pollen-robotics/lib_KiCAD/Templates/ASE00xyz-A1_elec_template_BOM.xlsx

ASE00 | A1 | Rainbow | DD/MM/202Y
Ref. | Value | Description | Quantity | Man. | Man. Ref.
