pollen-robotics/lib_KiCAD/3d_models/header_3p_215297-3.step

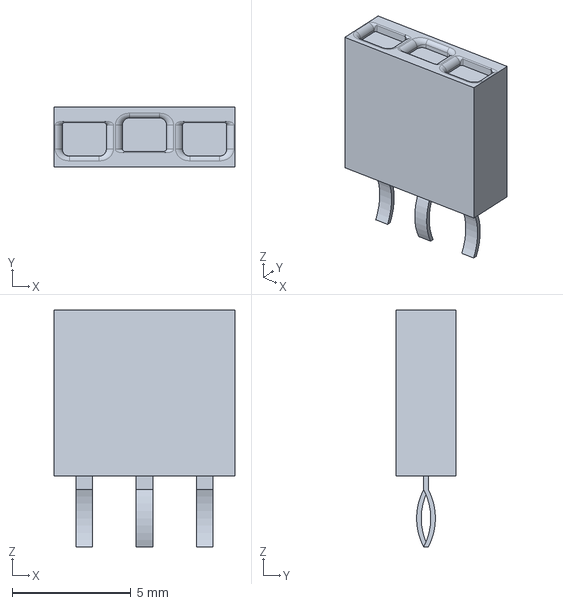
[picture p2: CAD file, 2026-09-16]
3d_models/header_3p_215297-3.step
7.62 x 2.52 x 10.0 mm
