pollen-robotics/lib_KiCAD/3d_models/RQM0029A.stp

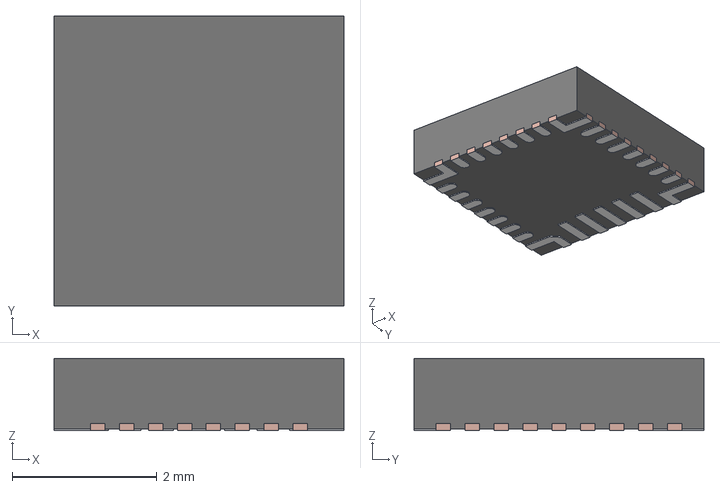
[picture p3: CAD file, 2026-09-15]
3d_models/RQM0029A.stp
4.00 x 4.00 x 1.00 mm
FRAME
MOLD
