pollen-robotics/lib_KiCAD/3d_models/HVQFN-32_L5.0-W5.0-P0.50-TL-EP3.1.step

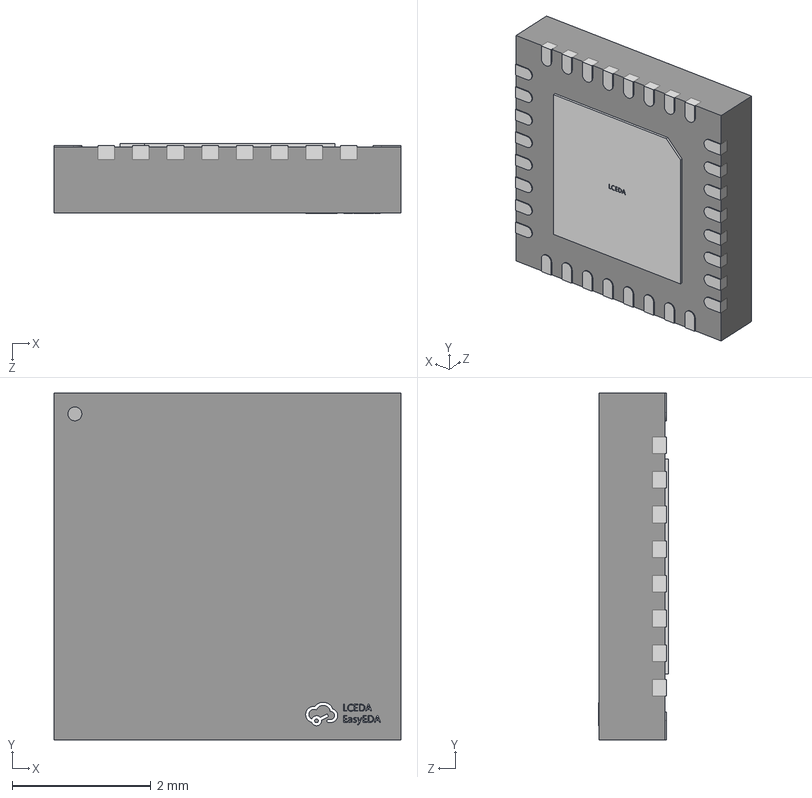
[picture p4: CAD file, 2026-07-10]
3d_models/HVQFN-32_L5.0-W5.0-P0.50-TL-EP3.1.step
5.00 x 5.00 x 1.01 mm
