pollen-robotics/lib_KiCAD/3d_models/Molex_pico4_TH_RA_0530480410.stp

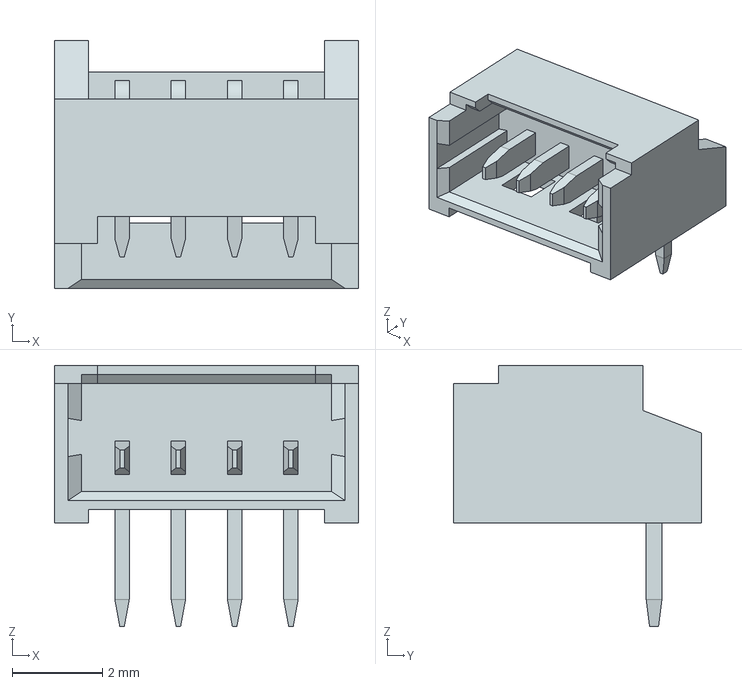
[picture p5: CAD file, 2026-04-16]
3d_models/Molex_pico4_TH_RA_0530480410.stp
6.75 x 5.50 x 5.80 mm
