pollen-robotics/lib_KiCAD/3d_models/Kailh_Choc_Low_Profile_Switch.step

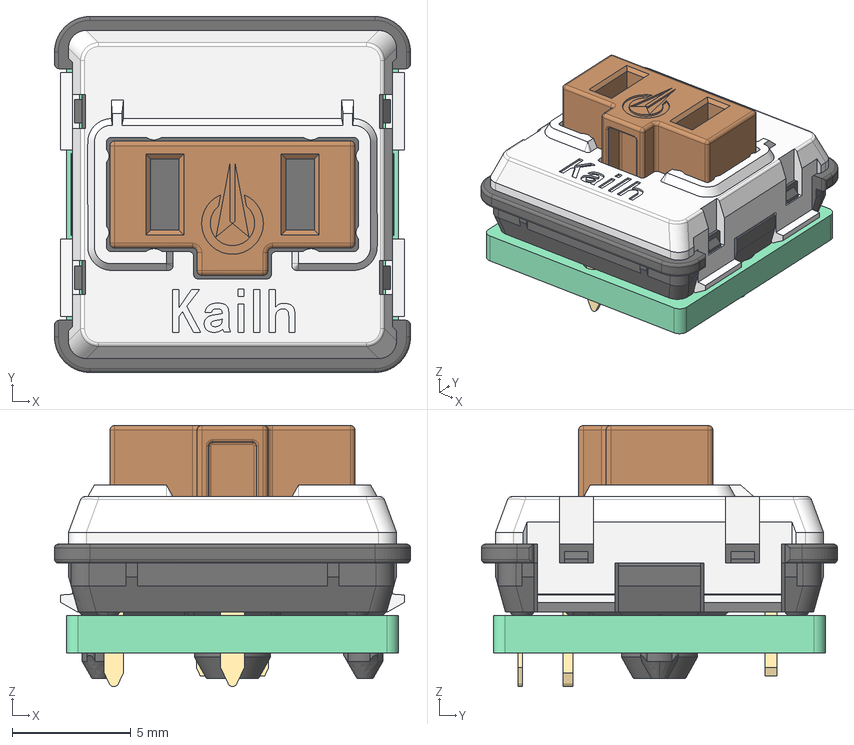
[picture p6: CAD file, 2026-03-20]
3d_models/Kailh_Choc_Low_Profile_Switch.step
15.0 x 15.0 x 11.0 mm
