pollen-robotics/lib_KiCAD/3d_models/rasp_pi_zero_2_W_with_40_pin_male_connector v4.step

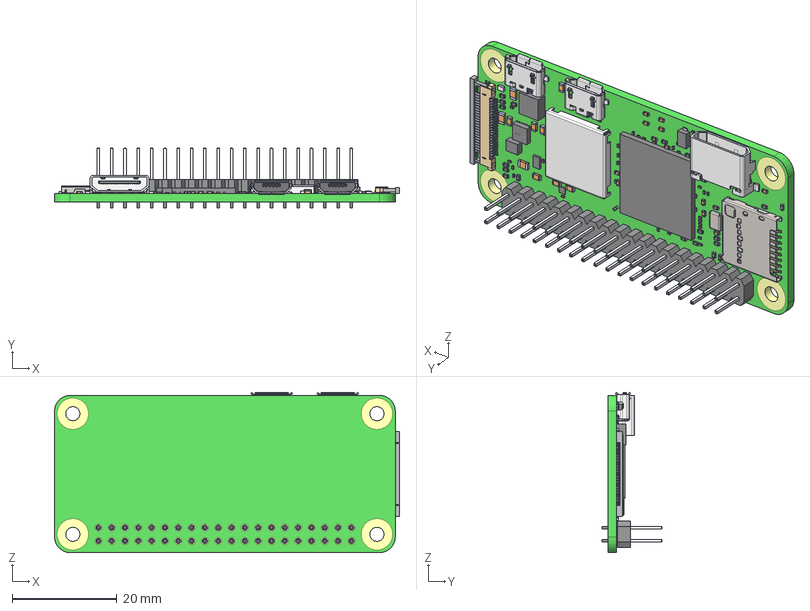
[picture p7: CAD file, 2026-02-24]
3d_models/rasp_pi_zero_2_W_with_40_pin_male_connector v4.step
65.8 x 11.5 x 30.6 mm
PCB, Raspberry Pi Zero 2 W
RP3A0-AU 2105 201221C, Raspberry Pi Zero 2 W
MicroUSB Port, Raspberry Pi Zero 2 W x 2
SD Card Slot, Raspberry Pi Zero 2 W
Wireless Module Cover, Raspberry Pi Zero 2 W
Crystal Resonator, Raspberry Pi Zero 2 W
LED, Raspberry Pi Zero 2 W
Diode, Schottky, Raspberry Pi Zero 2 W
54548-2271, 22 Pin FPC Connector, Raspberry Pi Zero 2 W
Mini HDMI Receptacle Port, Raspberry Pi Zero 2 W
PAM2306AYPKE, Switching Voltage Regulators Dual PWM Step-Down 40uA 1A 1.5MHz, Raspberry Pi Zero 2 W
RT9081A-1BGQZA, Fixed LDO Voltage Regulator, 0.8V-5.5Vin, 140mV drop, 1.25Vout, 0.5Aout, Raspberry Pi Zero 2 W_default
RT8088AWSC, IC Reg Buck Prog 3A Sync 15WLCSP, Raspberry Pi Zero 2 W_d efault
SMD Inductor, Configurable, Raspberry Pi Zero 2 W_L1
SMD Inductor, Configurable, Raspberry Pi Zero 2 W_L2
SMD Capacitor, Configurable, Raspberry Pi Zero 2 W_C1 x 3
SMD Capacitor, Configurable, Raspberry Pi Zero 2 W_C3 x 7
SMD Capacitor, Configurable, Raspberry Pi Zero 2 W_C2 x 31
SMD Capacitor, Configurable, Raspberry Pi Zero 2 W_C10 x 15
SMD Resistor, Configurable, Raspberry Pi Zero 2 W_R1 x 20
SMD Resistor, Configurable, Raspberry Pi Zero 2 W_R12
40 pin header male Raspberry PI v1
