pollen-robotics/lib_KiCAD/3d_models/Molex_pico4_TH_0530470410.stp

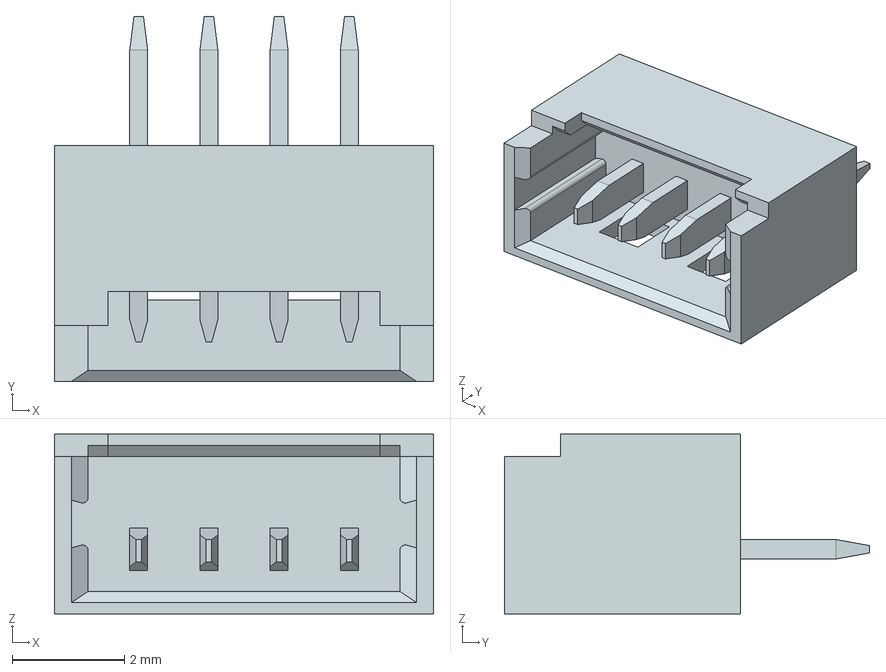
[picture p8: CAD file, 2026-02-09]
3d_models/Molex_pico4_TH_0530470410.stp
6.75 x 6.50 x 3.20 mm
