pollen-robotics/lib_KiCAD/3d_models/raps_CM4 -Light.step

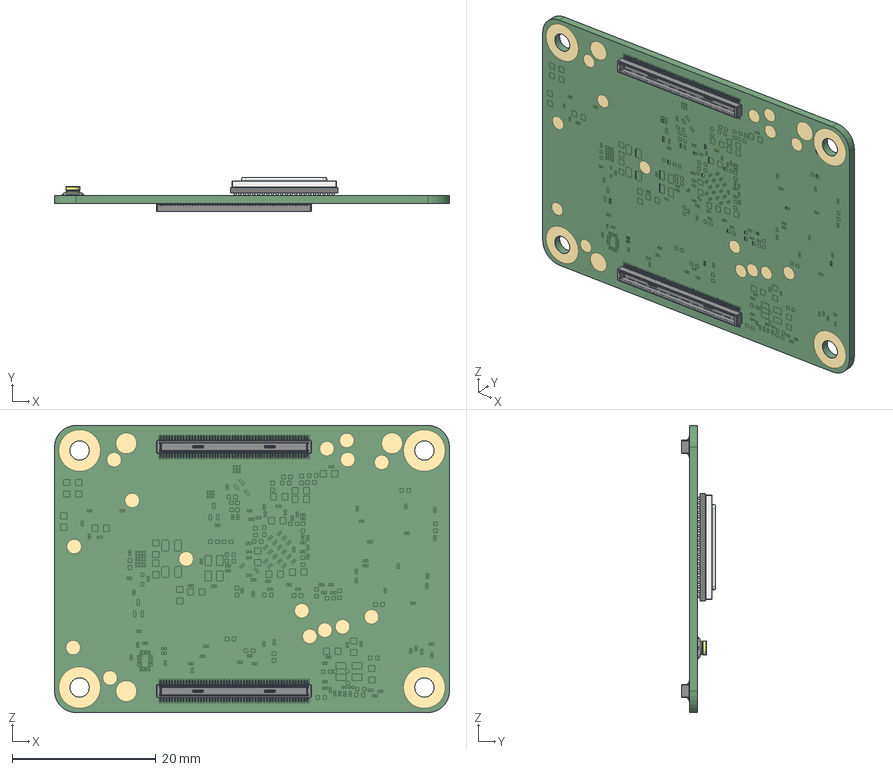
[picture p9: CAD file, 2026-01-26]
3d_models/raps_CM4 -Light.step
55.0 x 4.78 x 40.0 mm
