pollen-robotics/lib_KiCAD/3d_models/rasp_Cooler_RPI_CMx.step

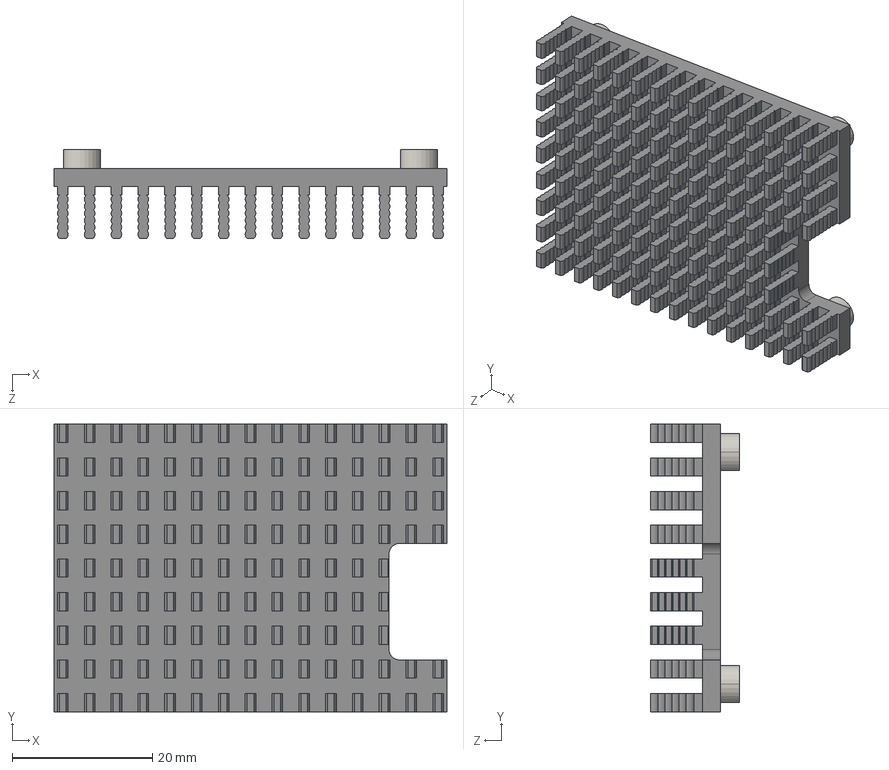
[picture p10: CAD file, 2026-01-26]
3d_models/rasp_Cooler_RPI_CMx.step
56.0 x 41.0 x 12.7 mm
