pollen-robotics/lib_KiCAD/3d_models/rasp_AI_HAT_Plus.stp

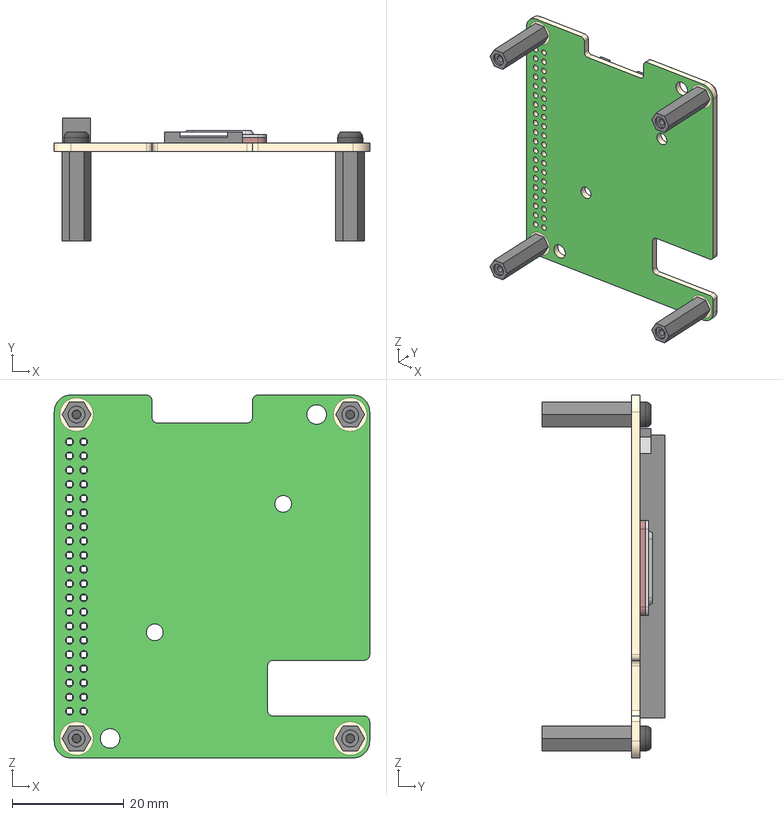
[picture p11: CAD file, 2026-01-26]
3d_models/rasp_AI_HAT_Plus.stp
56.5 x 22.1 x 65.0 mm
RPiAIHATPlusBoard
RPiAIHATPlusLeg x 4
RPiAIHATPlusScrew x 4
