pollen-robotics/lib_KiCAD/3d_models/Amass_XT30UPB-F.step

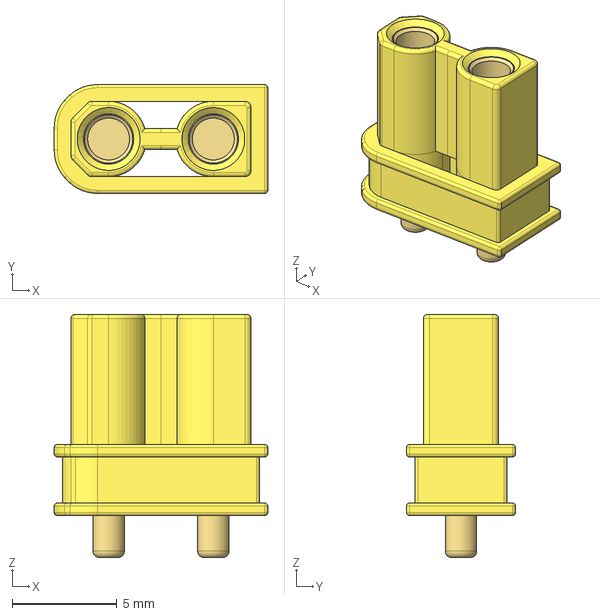
[picture p12: CAD file, 2025-12-03]
3d_models/Amass_XT30UPB-F.step
10.2 x 5.20 x 11.6 mm
