pollen-robotics/lib_KiCAD/3d_models/Vishay_SiC402_PowerPAK MLP55-32L.step

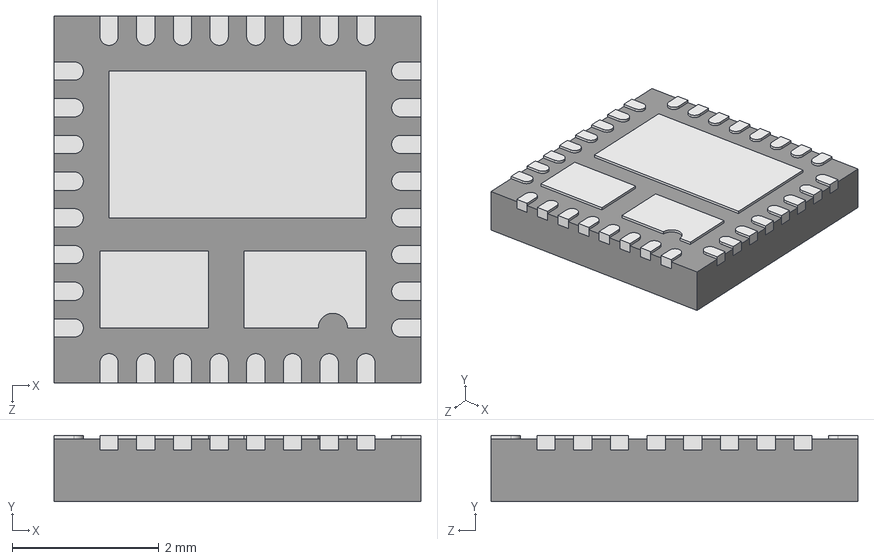
[picture p13: CAD file, 2025-11-20]
3d_models/Vishay_SiC402_PowerPAK MLP55-32L.step
5.00 x 0.9 x 5.00 mm
SiC402_body
SiC402_pinGND
SiC402_pinLX
SiC402_pinVIN
SiC402_pin x 32
SiC402_pinMark
