pollen-robotics/lib_KiCAD/3d_models/Amphenol_LUSBA11100.STEP

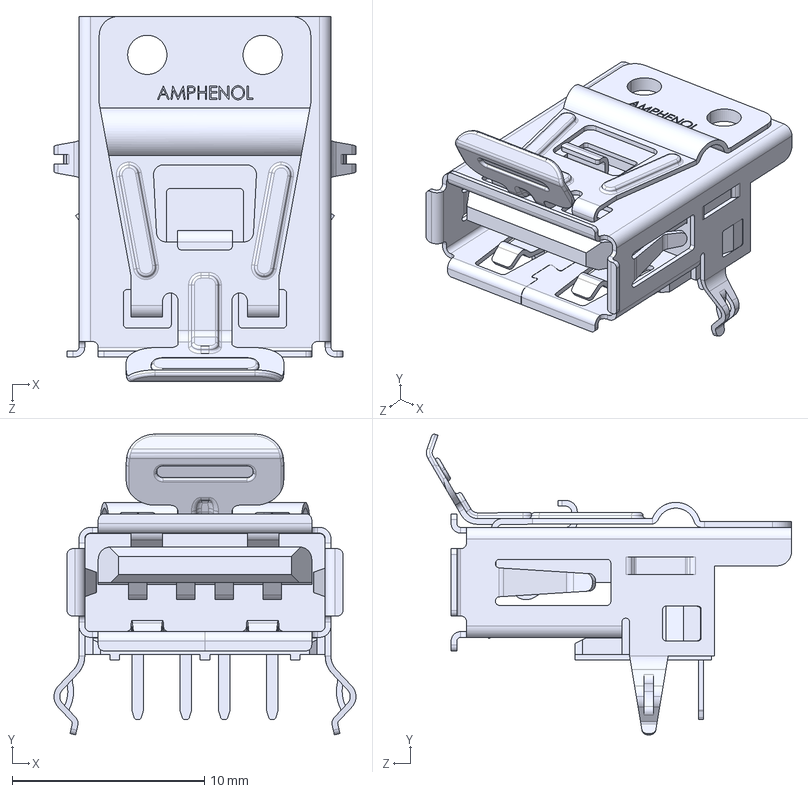
[picture p14: CAD file, 2025-10-06]
3d_models/Amphenol_LUSBA11100.STEP
15.7 x 15.6 x 19.0 mm
