pollen-robotics/lib_KiCAD/3d_models/Molex_430450612.stp

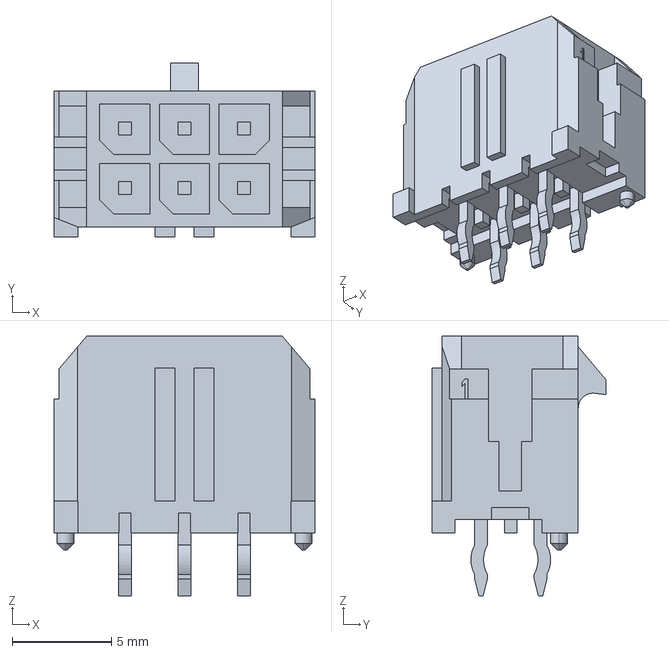
[picture p15: CAD file, 2025-09-02]
3d_models/Molex_430450612.stp
13.2 x 8.77 x 13.1 mm
