pollen-robotics/lib_KiCAD/3d_models/Amass_XT90PB-F.STEP

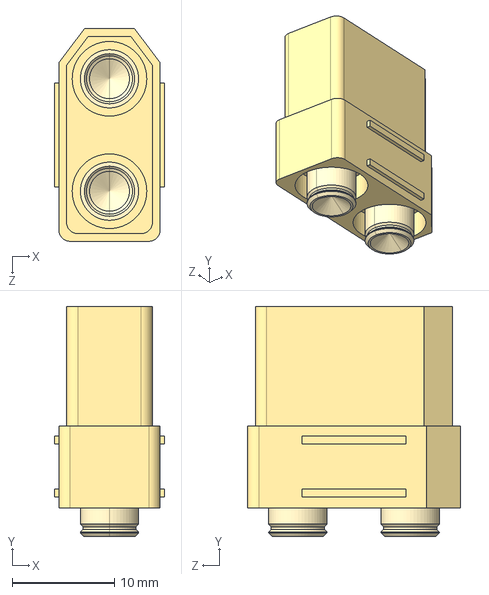
[picture p16: CAD file, 2025-09-02]
3d_models/Amass_XT90PB-F.STEP
10.8 x 22.5 x 20.8 mm
