pollen-robotics/lib_KiCAD/3d_models/TE_1734366-1.stp

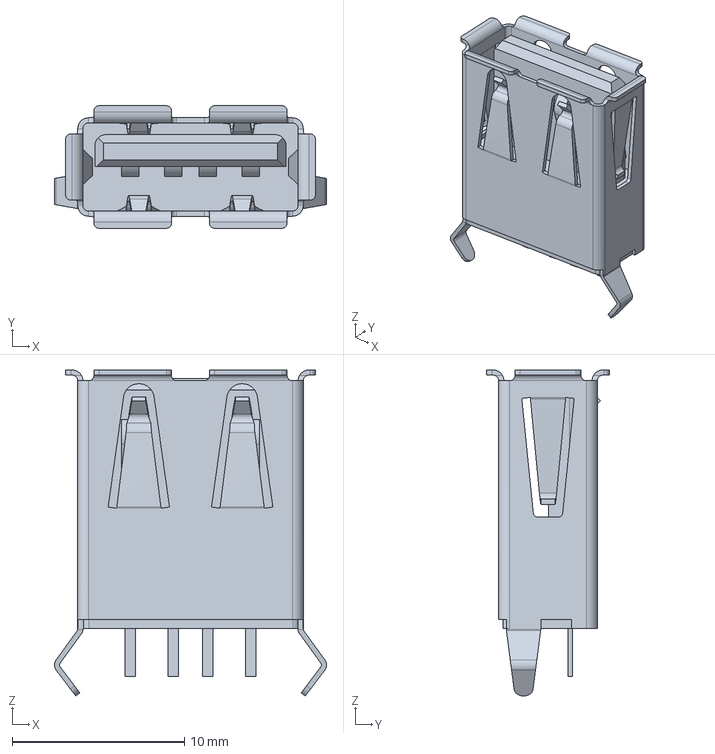
[picture p17: CAD file, 2025-09-02]
3d_models/TE_1734366-1.stp
15.8 x 7.12 x 18.9 mm
