pollen-robotics/lib_KiCAD/3d_models/MPKSLE60D20-L.step

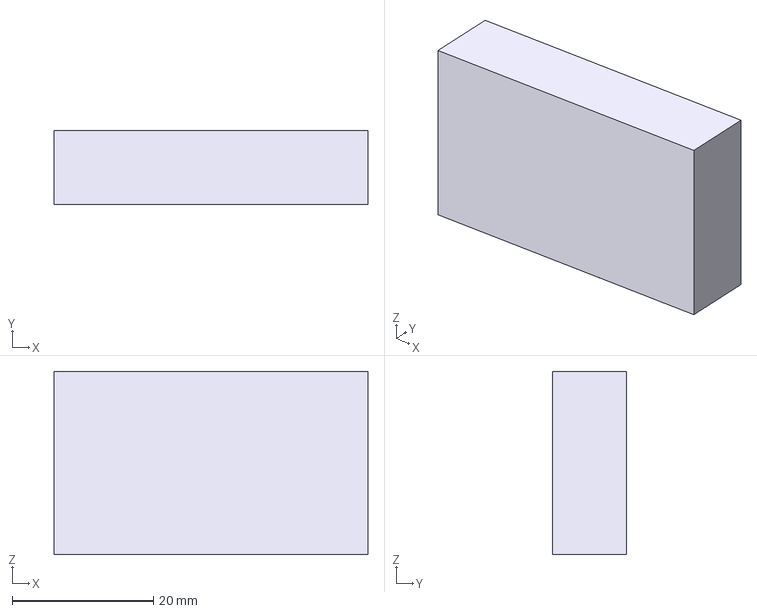
[picture p18: CAD file, 2025-09-02]
3d_models/MPKSLE60D20-L.step
44.5 x 10.5 x 26.0 mm
