pollen-robotics/lib_KiCAD/3d_models/Shou Han - USB TYPE-C 16PIN 2MD -073---3DModel-STEP-269445.STEP

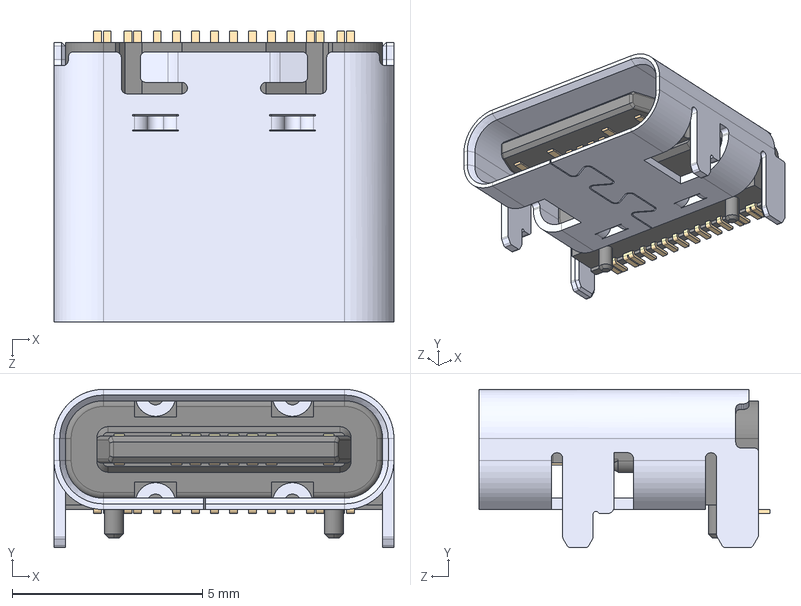
[picture p19: CAD file, 2025-06-26]
3d_models/Shou Han - USB TYPE-C 16PIN 2MD -073---3DModel-STEP-269445.STEP
8.94 x 4.16 x 7.65 mm
