pollen-robotics/lib_KiCAD/3d_models/FOO_USB-C_vert.STEP

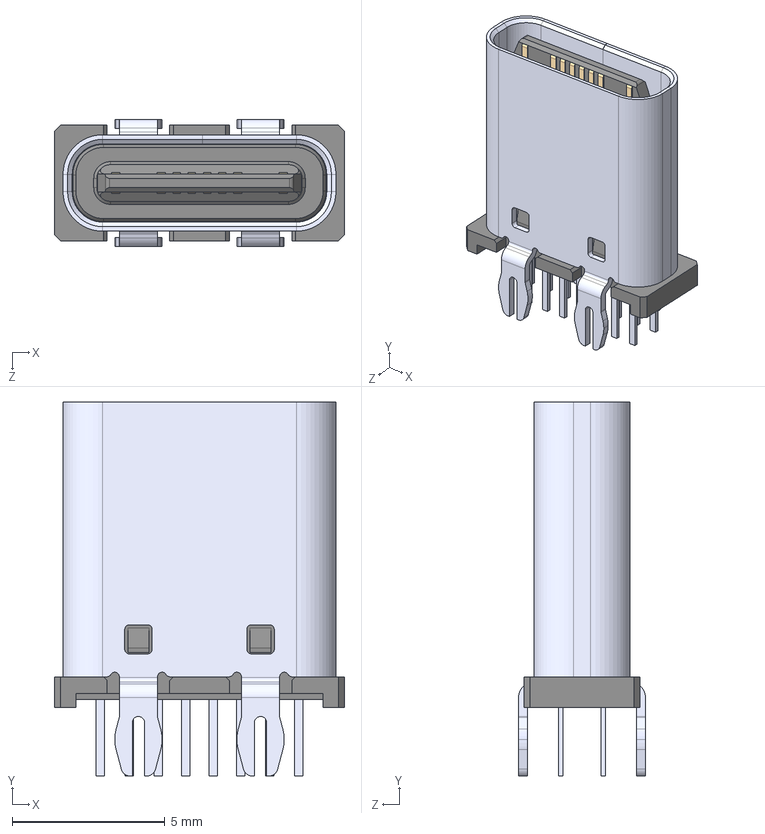
[picture p20: CAD file, 2025-06-26]
3d_models/FOO_USB-C_vert.STEP
9.50 x 12.2 x 4.16 mm
