pollen-robotics/lib_KiCAD/3d_models/DC005_jack_barrel.STEP

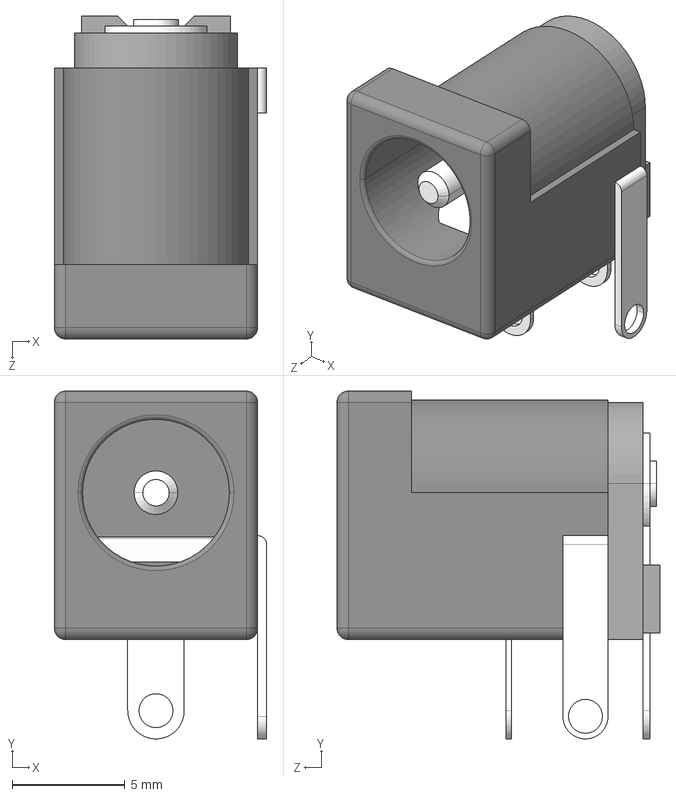
[picture p21: CAD file, 2025-06-26]
3d_models/DC005_jack_barrel.STEP
9.40 x 15.4 x 14.3 mm
