pollen-robotics/lib_KiCAD/3d_models/ss-3336s-02-l1.stp

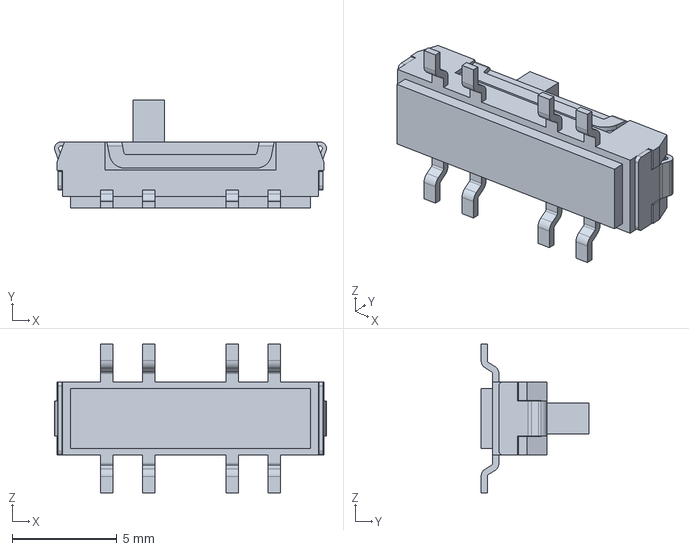
[picture p22: CAD file, 2025-06-26]
3d_models/ss-3336s-02-l1.stp
13.0 x 5.15 x 7.10 mm
