pollen-robotics/lib_KiCAD/3d_models/PowerSO20.STEP

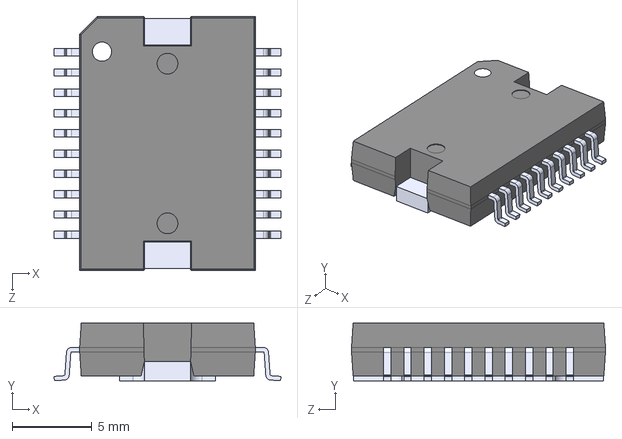
[picture p23: CAD file, 2025-06-26]
3d_models/PowerSO20.STEP
14.2 x 3.60 x 15.9 mm
