pollen-robotics/lib_KiCAD/3d_models/EOZ_09.03201.02.step

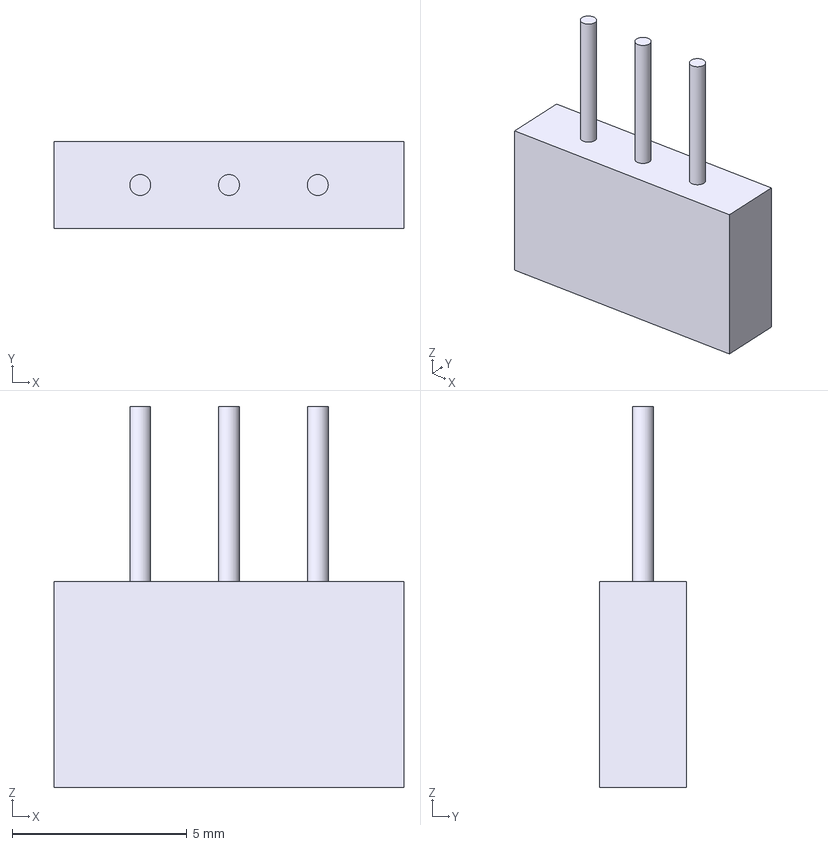
[picture p24: CAD file, 2025-02-03]
3d_models/EOZ_09.03201.02.step
10.0 x 2.50 x 10.9 mm
