pollen-robotics/lib_KiCAD/3d_models/Molex_430450212.stp

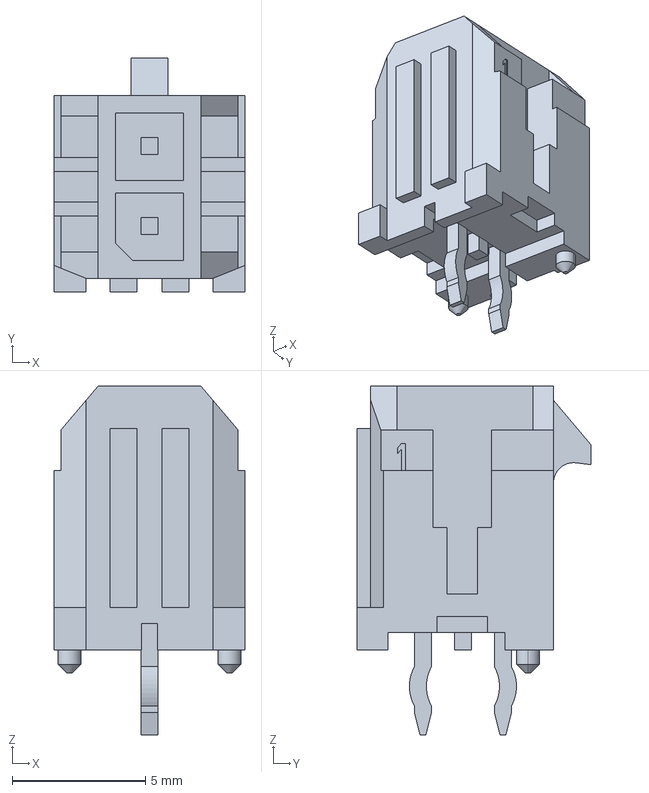
[picture p25: CAD file, 2024-11-15]
3d_models/Molex_430450212.stp
7.15 x 8.77 x 13.1 mm
