pollen-robotics/lib_KiCAD/3d_models/Molex_436500221.stp

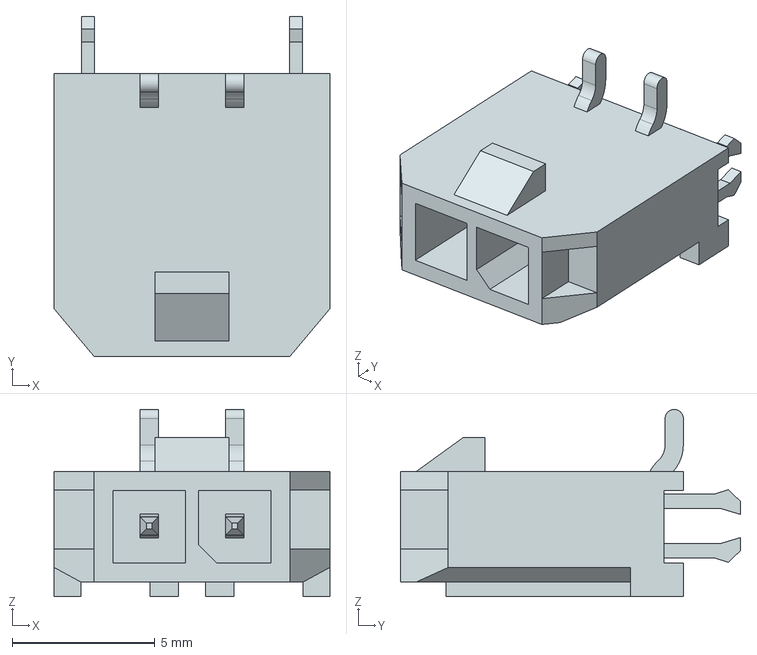
[picture p26: CAD file, 2024-11-07]
3d_models/Molex_436500221.stp
9.65 x 11.9 x 6.55 mm
