pollen-robotics/lib_KiCAD/3d_models/LPQFN20_ADI.step

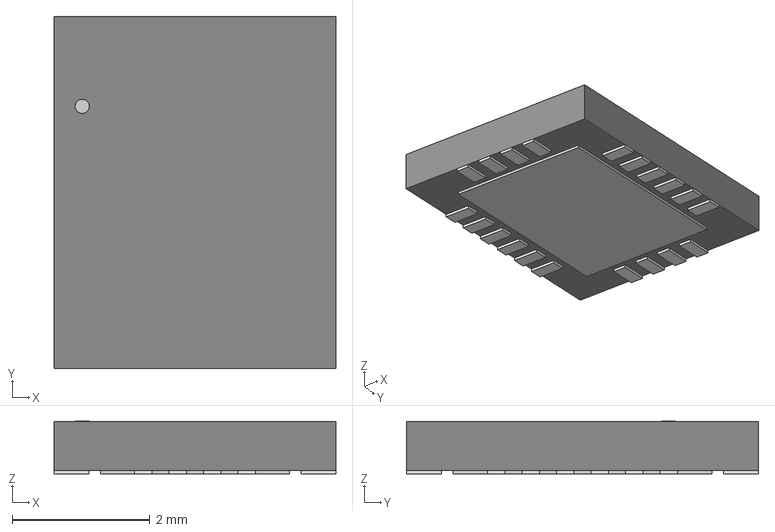
[picture p27: CAD file, 2024-10-08]
3d_models/LPQFN20_ADI.step
4.09 x 5.11 x 0.765 mm
