pollen-robotics/lib_KiCAD/3d_models/QFN-16 (3x3).stp

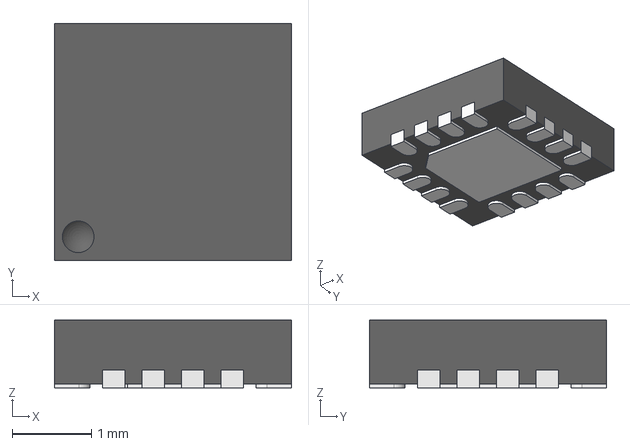
[picture p28: CAD file, 2024-09-25]
3d_models/QFN-16 (3x3).stp
3.00 x 3.00 x 0.86 mm
QFN-16 (3x3) Part1
QFN-16 (3x3) Part2 x 16
