pollen-robotics/lib_KiCAD/3d_models/TE_5787834-1.stp

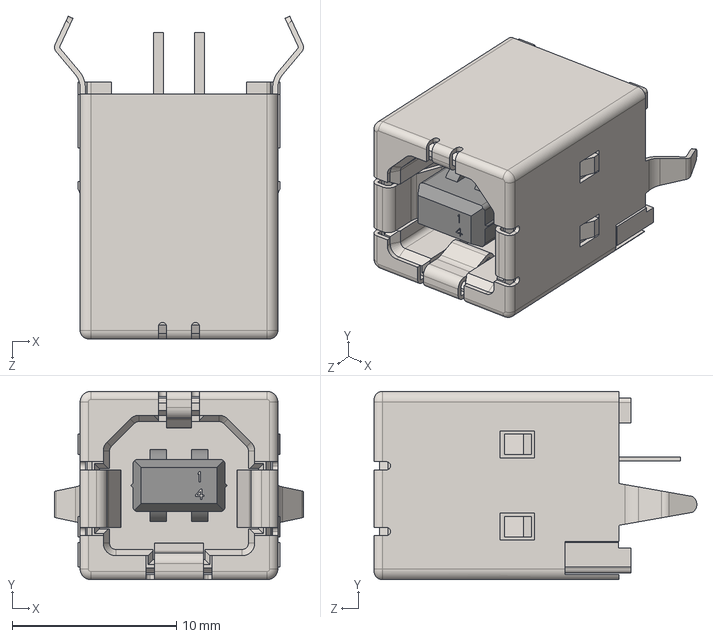
[picture p29: CAD file, 2024-08-23]
3d_models/TE_5787834-1.stp
15.1 x 11.5 x 19.6 mm
