pollen-robotics/lib_KiCAD/3d_models/Molex_105133-0001.stp

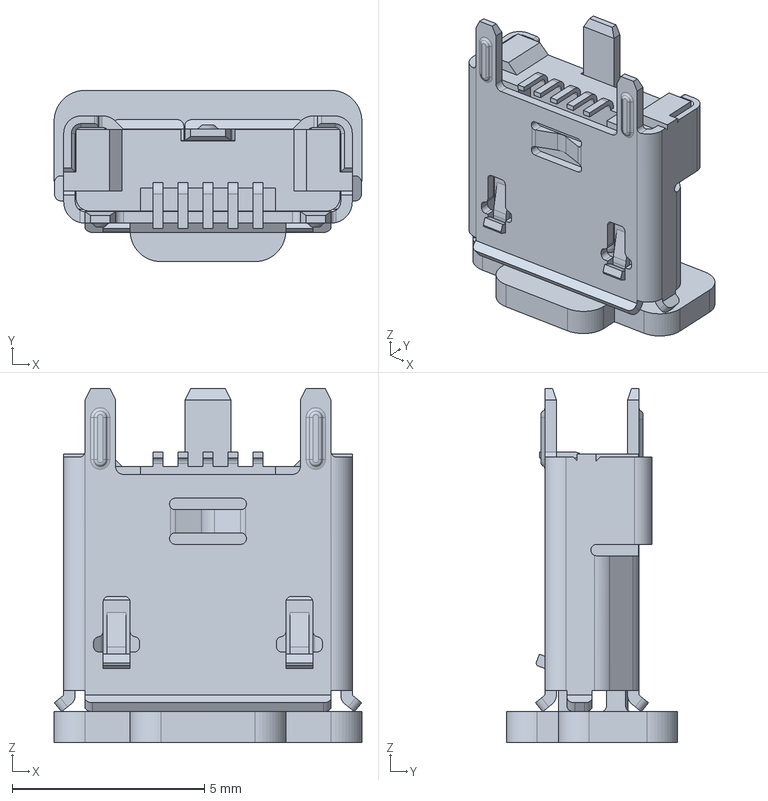
[picture p30: CAD file, 2024-08-23]
3d_models/Molex_105133-0001.stp
8.00 x 4.45 x 9.20 mm
