pollen-robotics/lib_KiCAD/3d_models/ERJ8CWFR010V.step

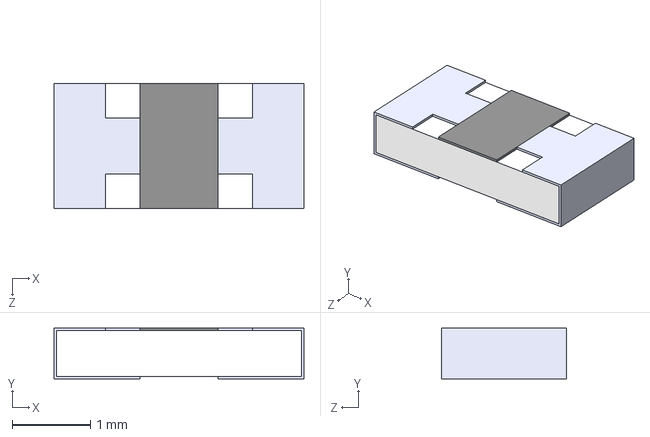
[picture p31: CAD file, 2024-07-12]
3d_models/ERJ8CWFR010V.step
3.20 x 0.65 x 1.60 mm
