pollen-robotics/lib_KiCAD/3d_models/Molex_539160208.stp

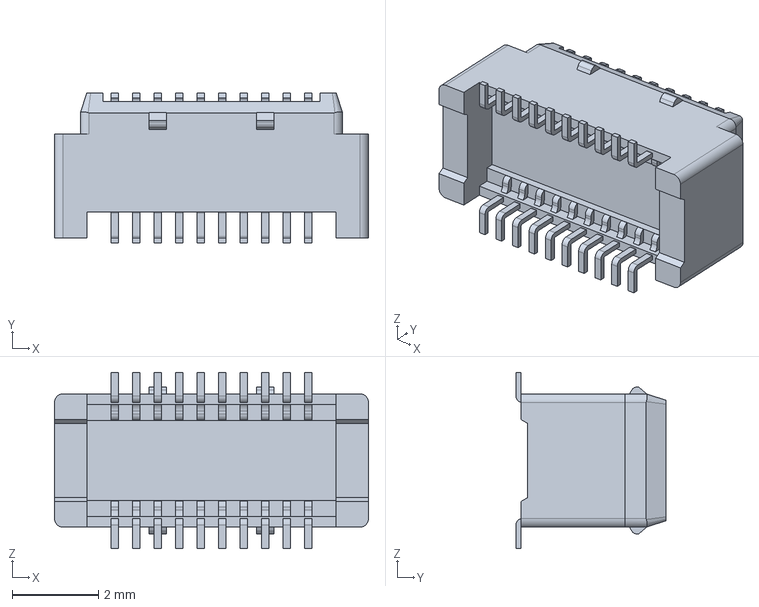
[picture p32: CAD file, 2024-05-10]
3d_models/Molex_539160208.stp
7.30 x 3.49 x 4.10 mm
