pollen-robotics/lib_KiCAD/3d_models/Molex_529910208.stp

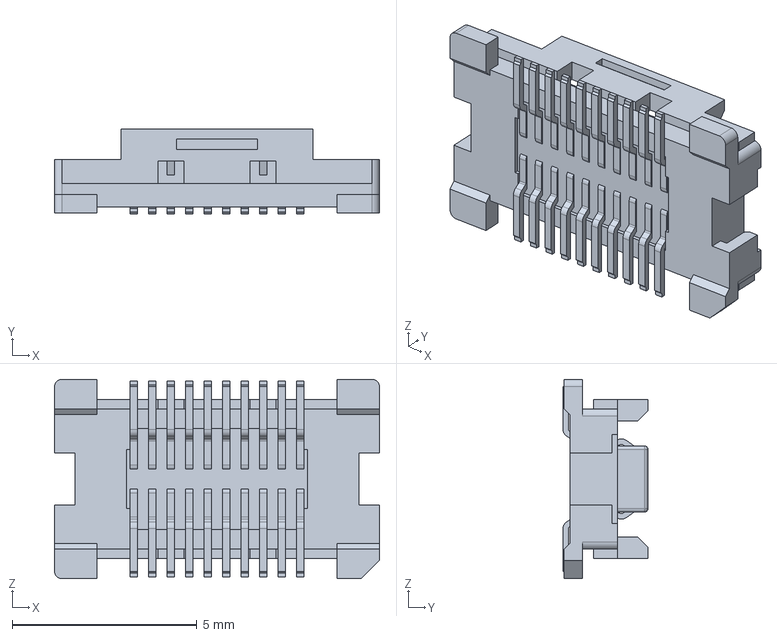
[picture p33: CAD file, 2024-05-10]
3d_models/Molex_529910208.stp
8.80 x 2.30 x 5.40 mm
