pollen-robotics/lib_KiCAD/3d_models/KW_DSLP31_CC_20191212_geometry.STEP

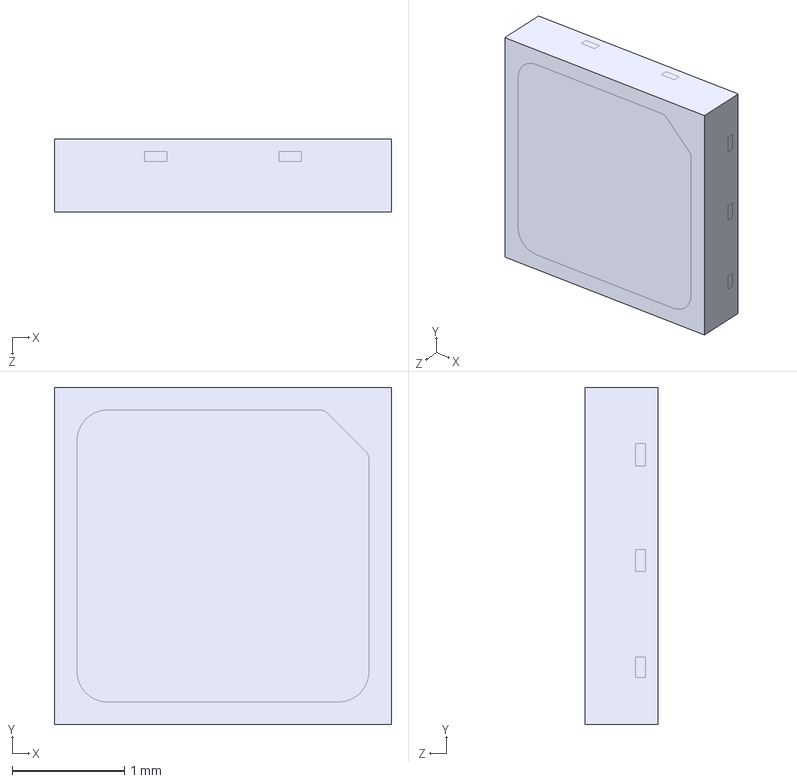
[picture p34: CAD file, 2024-03-18]
3d_models/KW_DSLP31_CC_20191212_geometry.STEP
3.00 x 3.00 x 0.65 mm
