pollen-robotics/lib_KiCAD/3d_models/QFN37_7X7_TRI.step

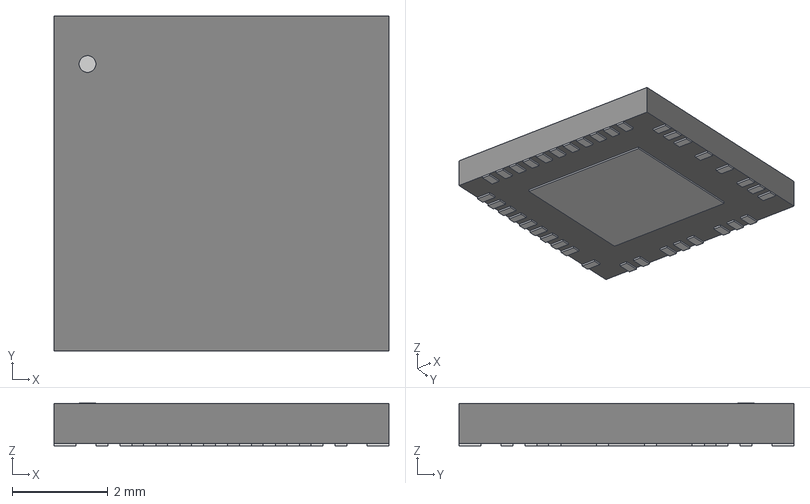
[picture p35: CAD file, 2024-03-18]
3d_models/QFN37_7X7_TRI.step
7.01 x 7.01 x 0.892 mm
