pollen-robotics/lib_KiCAD/3d_models/Molex_502352-0400.stp

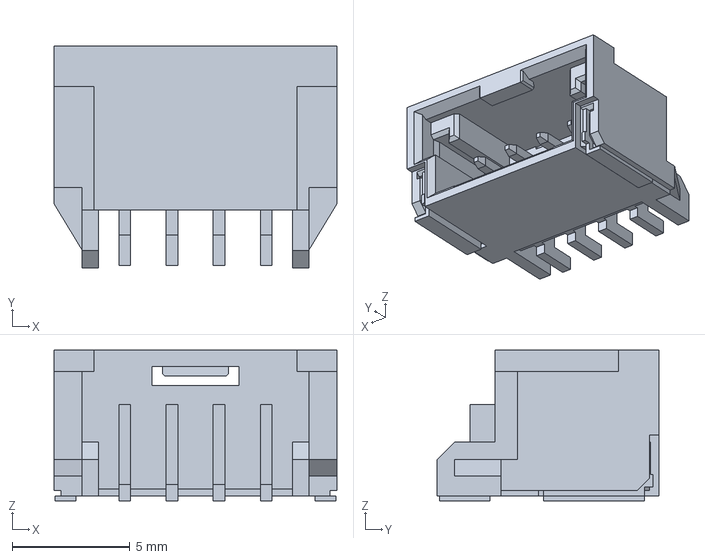
[picture p36: CAD file, 2024-03-18]
3d_models/Molex_502352-0400.stp
12.0 x 9.40 x 6.40 mm
