pollen-robotics/lib_KiCAD/3d_models/PQFN-12.step

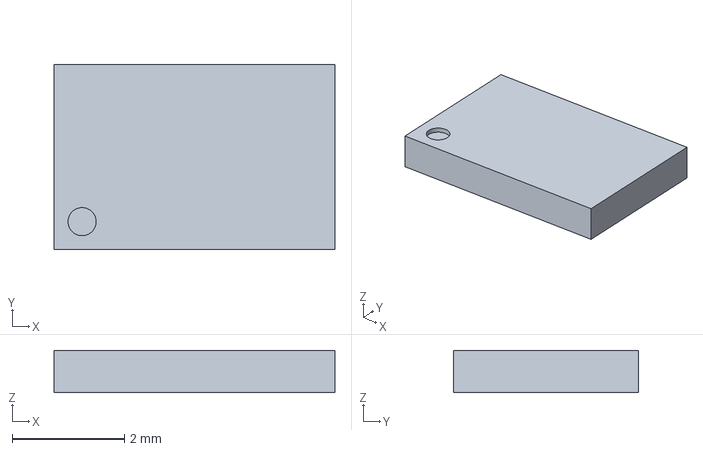
[picture p37: CAD file, 2024-03-18]
3d_models/PQFN-12.step
5.00 x 3.30 x 0.75 mm
