pollen-robotics/lib_KiCAD/3d_models/VQFN-40_5x7mm.stp

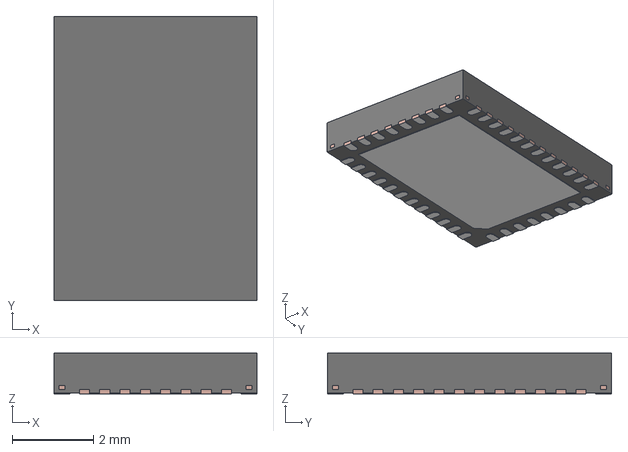
[picture p38: CAD file, 2024-03-08]
3d_models/VQFN-40_5x7mm.stp
5.00 x 7.00 x 1.00 mm
FRAME
