pollen-robotics/lib_KiCAD/3d_models/Amass_XT30U-F.stp

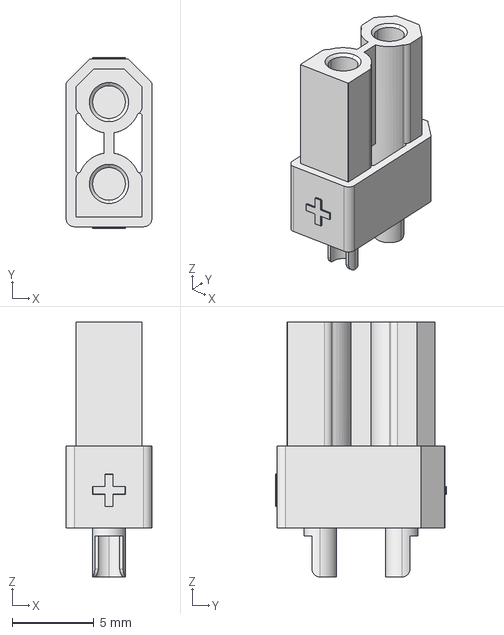
[picture p39: CAD file, 2024-01-29]
3d_models/Amass_XT30U-F.stp
5.25 x 10.4 x 15.6 mm
