pollen-robotics/lib_KiCAD/3d_models/Molex_530470210.stp

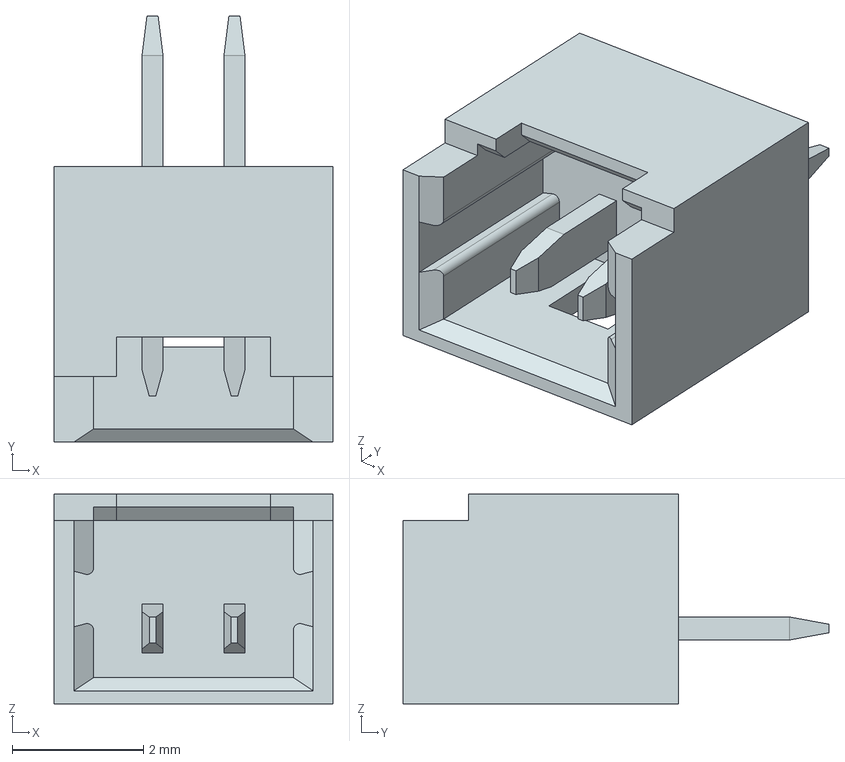
[picture p40: CAD file, 2024-01-29]
3d_models/Molex_530470210.stp
4.25 x 6.50 x 3.20 mm
