pollen-robotics/lib_KiCAD/3d_models/Amass_XT30U_M.step

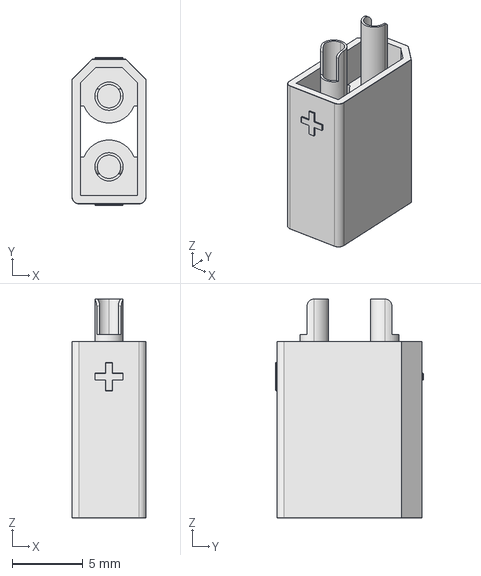
[picture p41: CAD file, 2024-01-29]
3d_models/Amass_XT30U_M.step
5.25 x 10.4 x 15.5 mm
