pollen-robotics/lib_KiCAD/3d_models/Fuse_Holder_Schurter_8040.0001_03.STEP

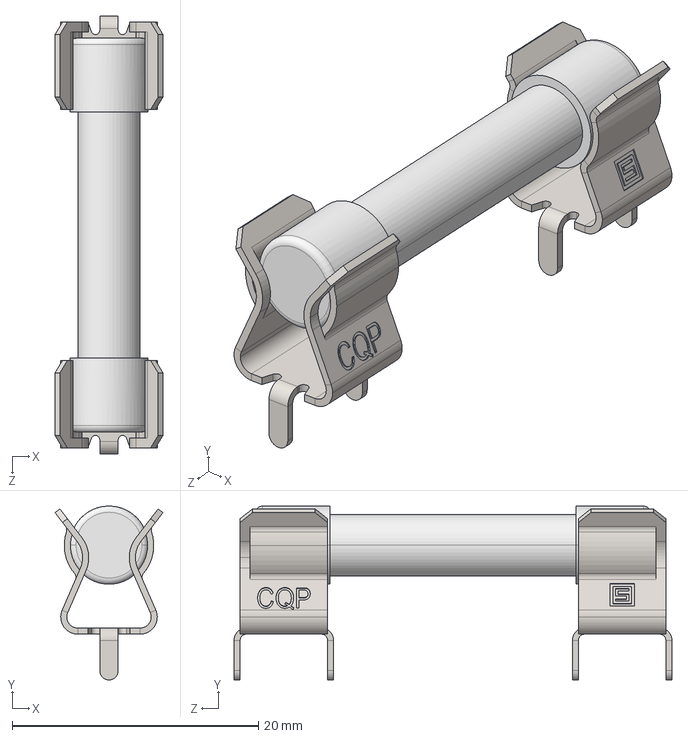
[picture p42: CAD file, 2024-01-29]
3d_models/Fuse_Holder_Schurter_8040.0001_03.STEP
8.77 x 14.1 x 35.6 mm
