pollen-robotics/lib_KiCAD/3d_models/Amass_XT90H-M.STEP

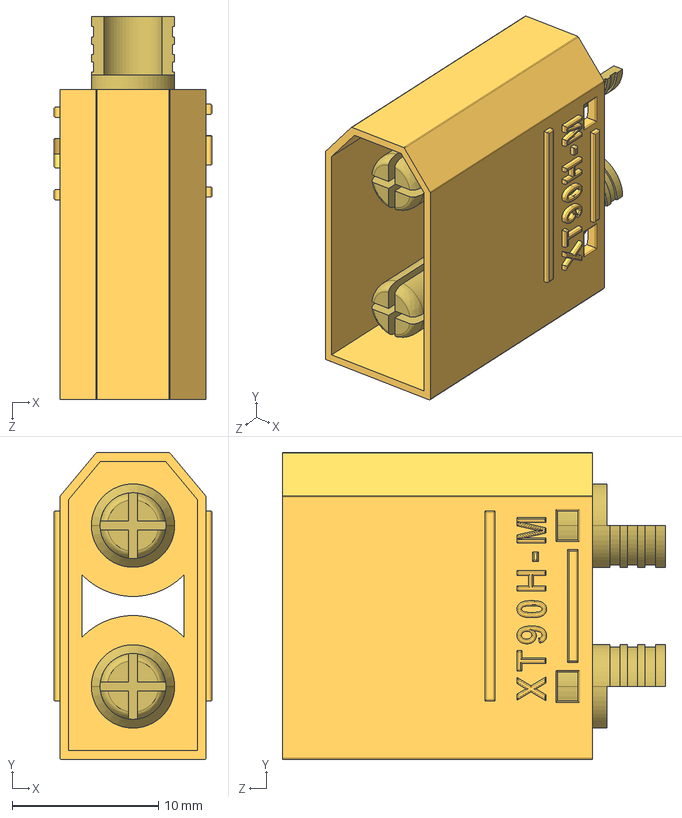
[picture p43: CAD file, 2024-01-29]
3d_models/Amass_XT90H-M.STEP
10.8 x 21.0 x 26.2 mm
