pollen-robotics/lib_KiCAD/3d_models/Amass_XT90H-F.STEP

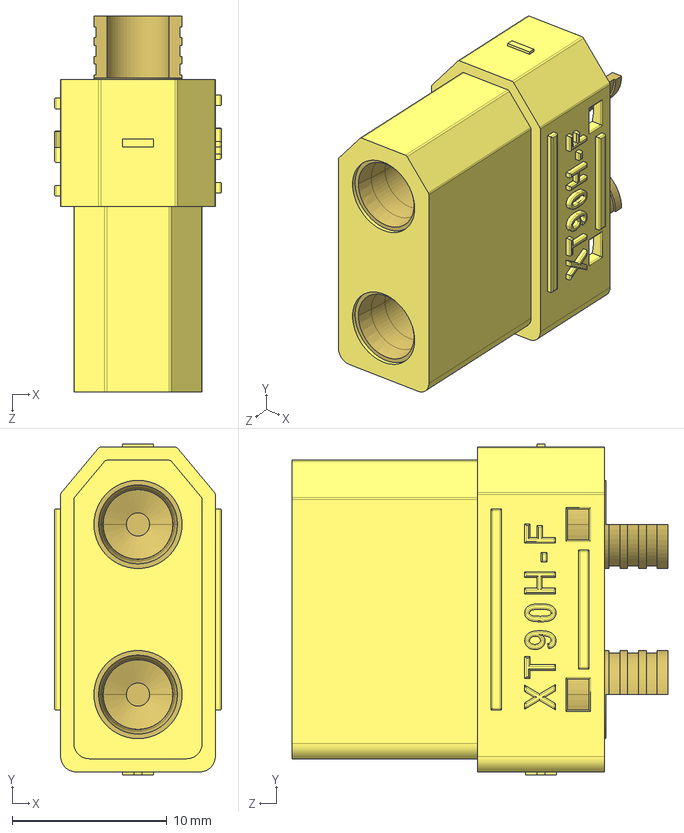
[picture p44: CAD file, 2024-01-29]
3d_models/Amass_XT90H-F.STEP
10.8 x 21.4 x 24.3 mm
XT90H-F body
XT90H-F pin x 2
