pollen-robotics/lib_KiCAD/3d_models/Molex_436500215.stp

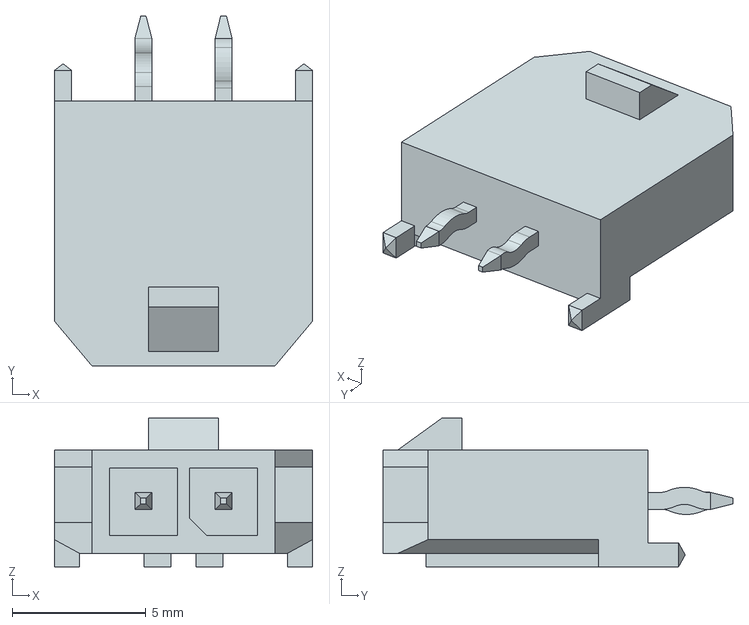
[picture p45: CAD file, 2024-01-29]
3d_models/Molex_436500215.stp
9.65 x 13.1 x 5.57 mm
