pollen-robotics/lib_KiCAD/3d_models/Amass_XT30PW-M_pcb solder.stp

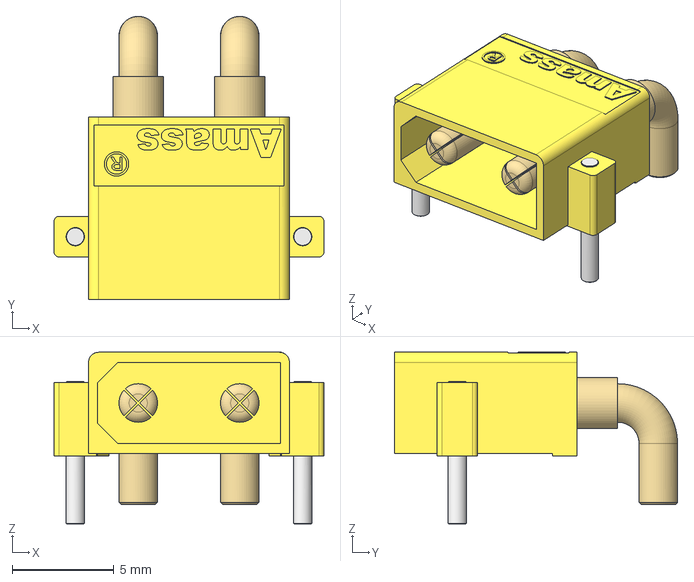
[picture p46: CAD file, 2024-01-17]
3d_models/Amass_XT30PW-M_pcb solder.stp
13.3 x 13.9 x 8.45 mm
