pollen-robotics/lib_KiCAD/3d_models/Molex_MegaFit_2002411212.stp

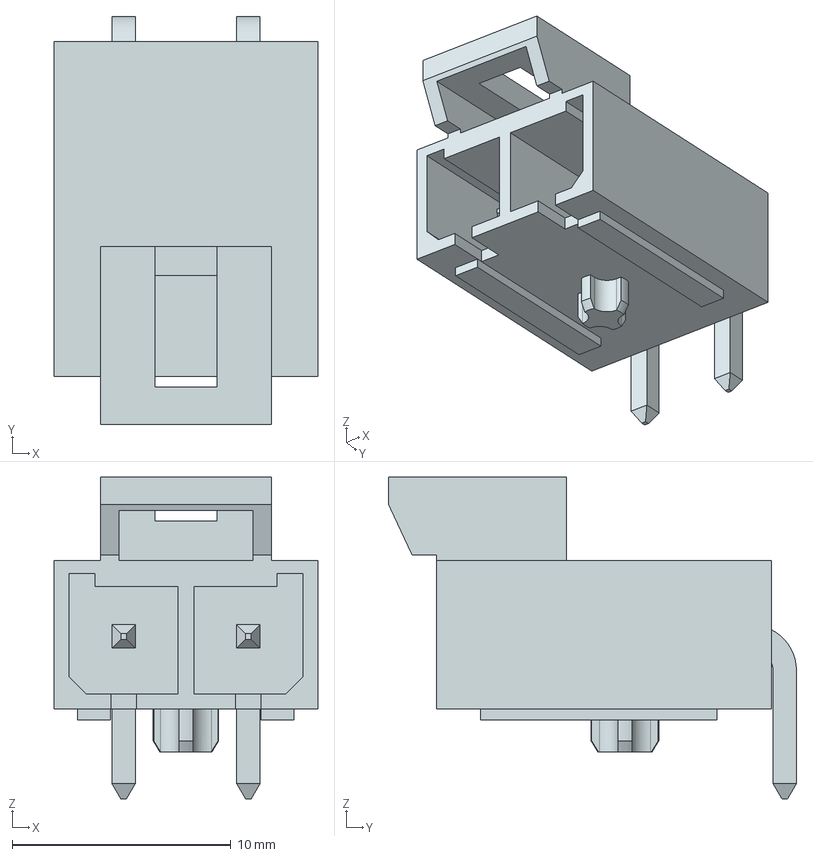
[picture p47: CAD file, 2024-01-17]
3d_models/Molex_MegaFit_2002411212.stp
12.1 x 18.6 x 14.7 mm
