pollen-robotics/lib_KiCAD/3d_models/capacitor_diam_6.3mm_P2.50mm_h11.step

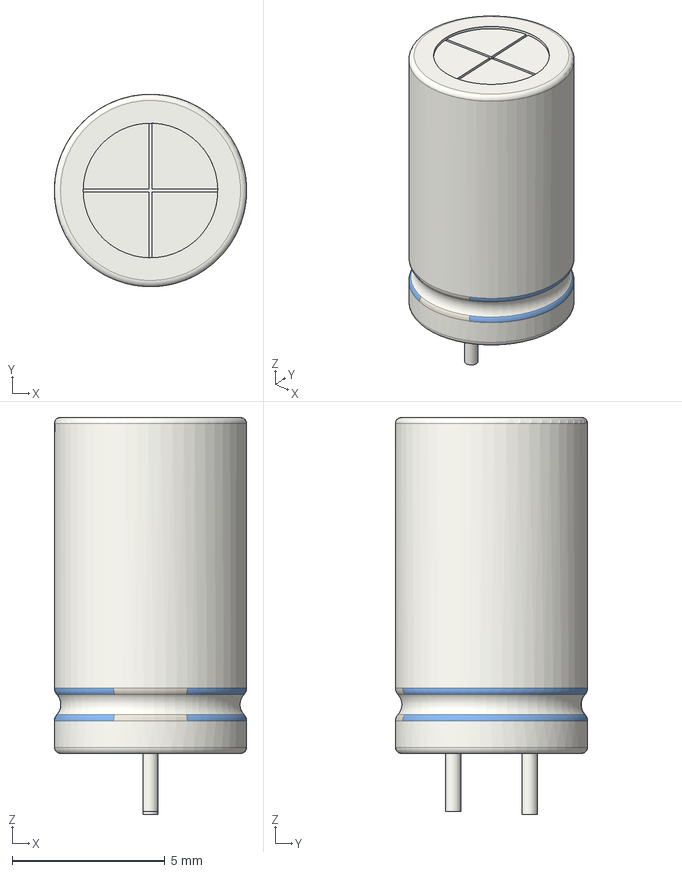
[picture p48: CAD file, 2023-12-18]
3d_models/capacitor_diam_6.3mm_P2.50mm_h11.step
6.30 x 6.30 x 13.0 mm
