pollen-robotics/lib_KiCAD/3d_models/Molex_43650-0300.stp

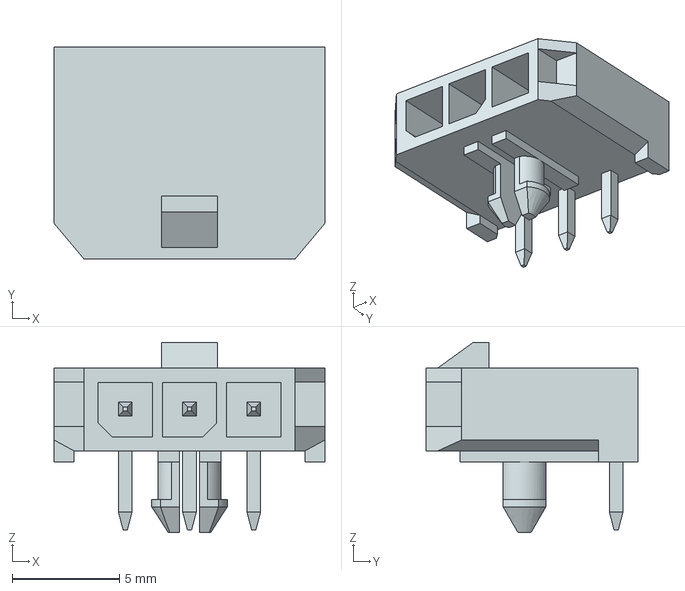
[picture p49: CAD file, 2023-12-18]
3d_models/Molex_43650-0300.stp
12.7 x 9.90 x 8.87 mm
