pollen-robotics/lib_KiCAD/3d_models/Molex_43650-0200.stp

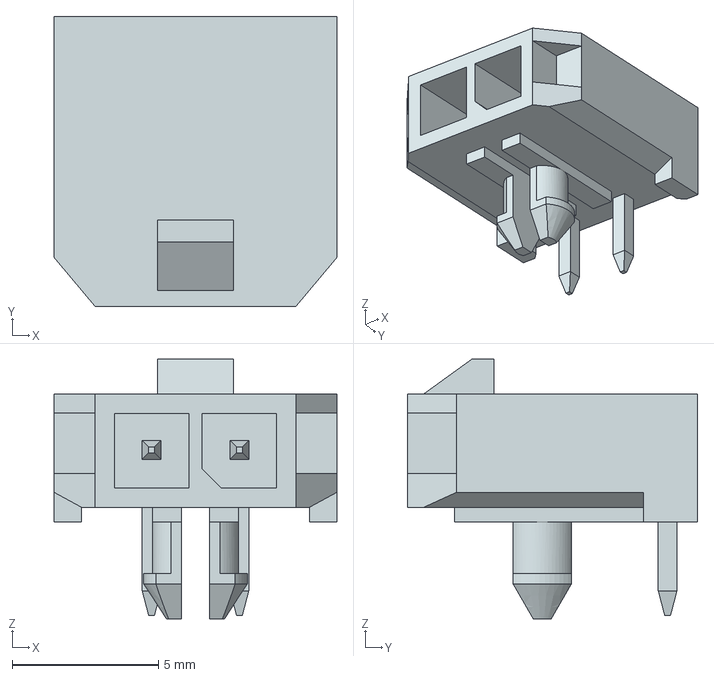
[picture p50: CAD file, 2023-12-18]
3d_models/Molex_43650-0200.stp
9.65 x 9.90 x 8.87 mm
