pollen-robotics/lib_KiCAD/3d_models/capacitor_diam_12.5_code_H13.stp

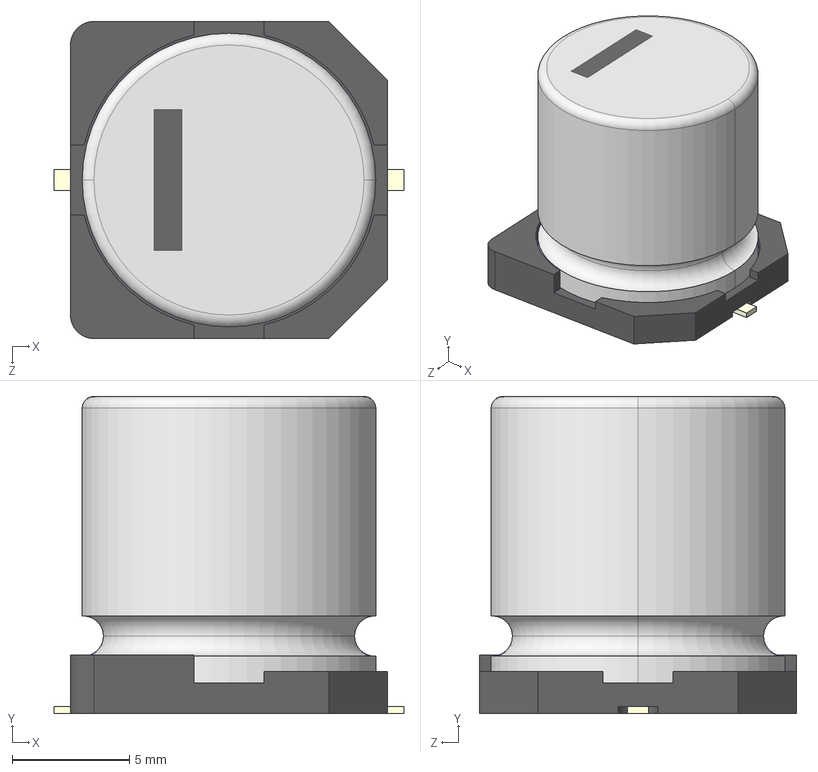
[picture p51: CAD file, 2023-11-27]
3d_models/capacitor_diam_12.5_code_H13.stp
14.9 x 13.5 x 13.5 mm
標準SIZE CODE H13-001
標準SIZE CODE H13-002
標準SIZE CODE H13-003 x 2
