pollen-robotics/lib_KiCAD/3d_models/Molex_SPOX_5267-03A_Dynamixel.step

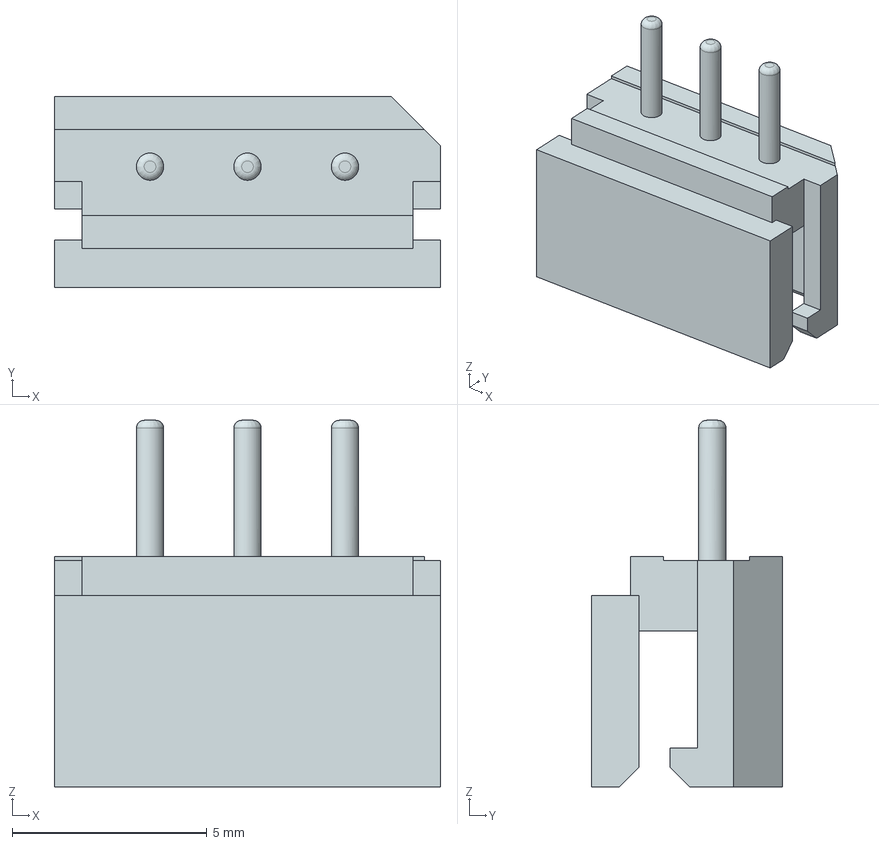
[picture p52: CAD file, 2023-08-28]
3d_models/Molex_SPOX_5267-03A_Dynamixel.step
9.90 x 4.90 x 9.40 mm
