pollen-robotics/lib_KiCAD/3d_models/QFN76_11P5X6P5_TRI.step

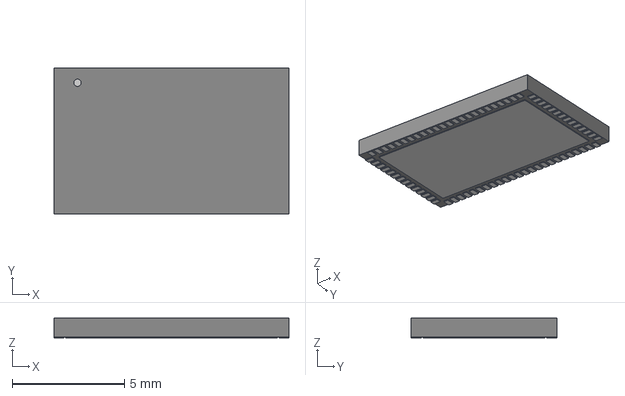
[picture p53: CAD file, 2023-07-27]
3d_models/QFN76_11P5X6P5_TRI.step
10.5 x 6.50 x 0.892 mm
