pollen-robotics/lib_KiCAD/3d_models/c-338728-8-g-3d.stp

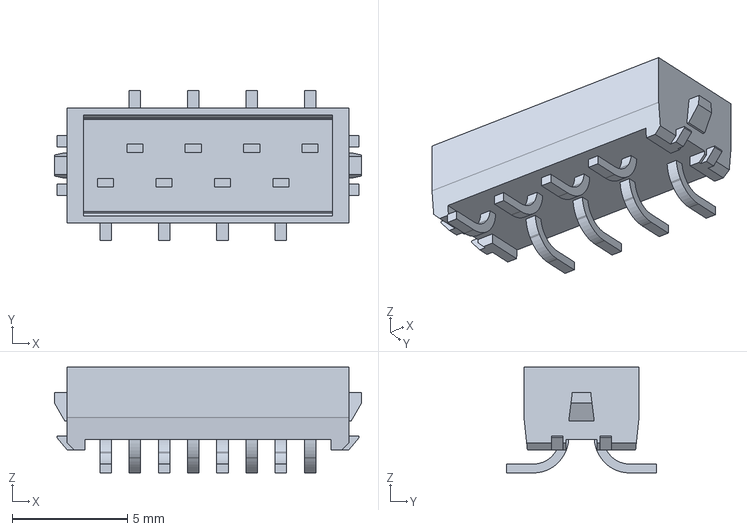
[picture p54: CAD file, 2023-07-27]
3d_models/c-338728-8-g-3d.stp
13.3 x 6.50 x 4.60 mm
