pollen-robotics/lib_KiCAD/3d_models/ASE-xx.yyyMHZ-ET.stp

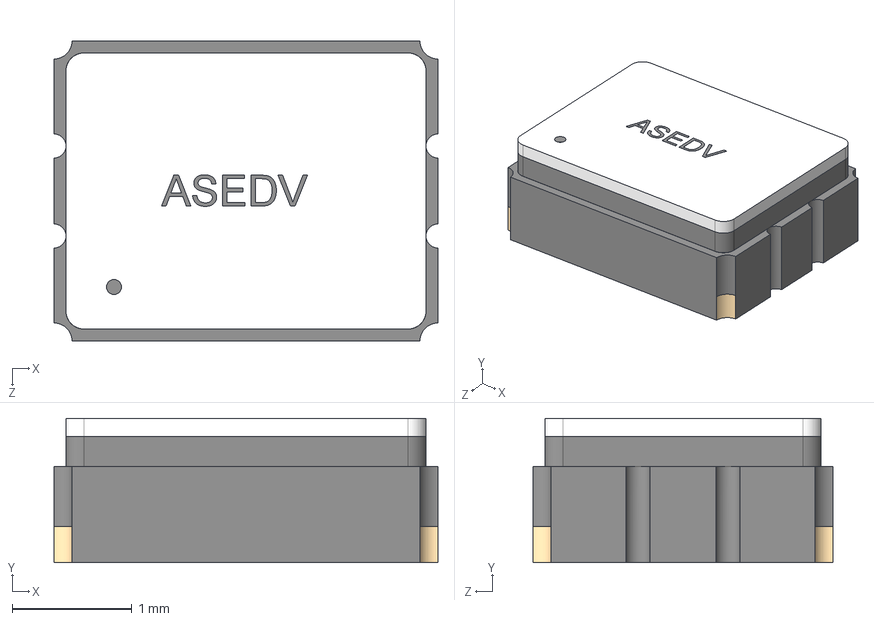
[picture p55: CAD file, 2023-07-27]
3d_models/ASE-xx.yyyMHZ-ET.stp
3.20 x 1.20 x 2.50 mm
