pollen-robotics/lib_KiCAD/3d_models/BSZ034N04LS.STEP

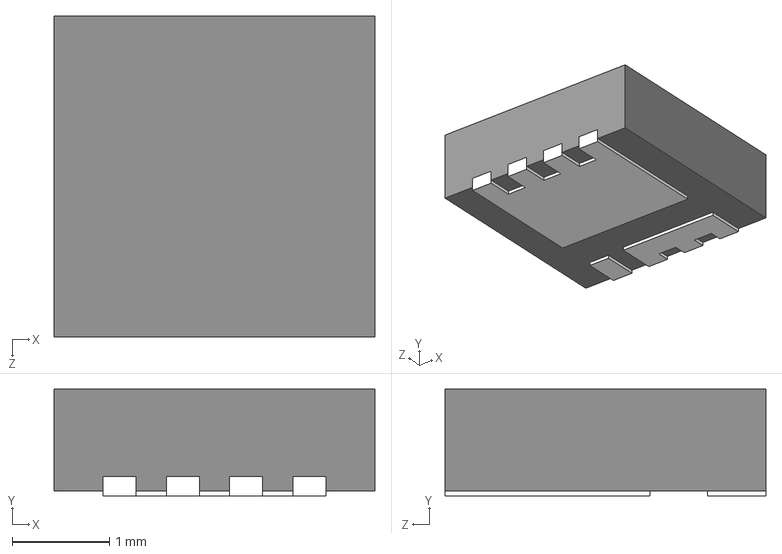
[picture p56: CAD file, 2023-07-27]
3d_models/BSZ034N04LS.STEP
3.30 x 1.10 x 3.30 mm
