pollen-robotics/lib_KiCAD/3d_models/C&K_-_KMR221NGLFS.step

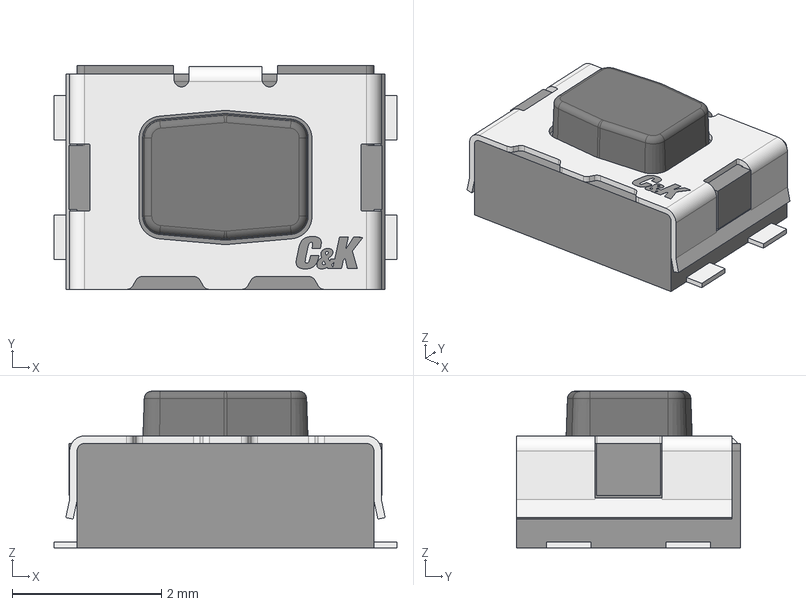
[picture p57: CAD file, 2023-07-27]
3d_models/C&K_-_KMR221NGLFS.step
4.60 x 3.00 x 2.10 mm
Button
Boitier
Tole
Pads
C&K
