pollen-robotics/lib_KiCAD/3d_models/DF20F-10DP-1V.stp

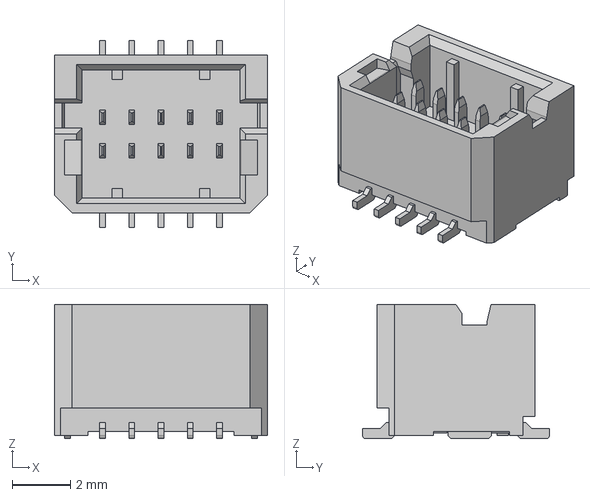
[picture p58: CAD file, 2023-07-27]
3d_models/DF20F-10DP-1V.stp
7.30 x 6.40 x 4.60 mm
