pollen-robotics/lib_KiCAD/3d_models/eTQFP48_9x9_TRI.step

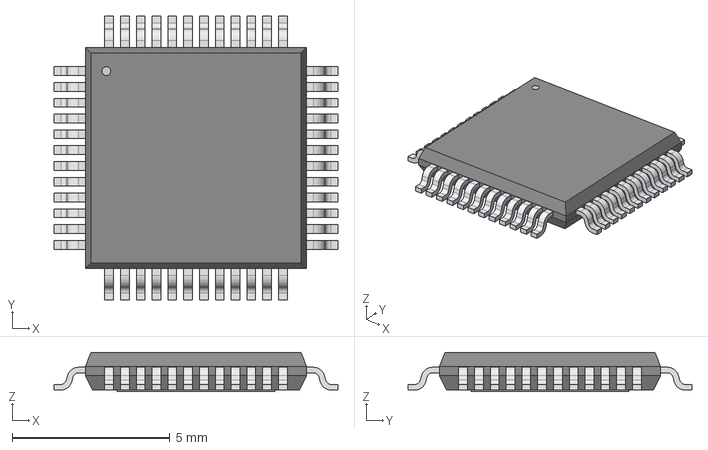
[picture p59: CAD file, 2023-07-27]
3d_models/eTQFP48_9x9_TRI.step
8.99 x 8.99 x 1.25 mm
