pollen-robotics/lib_KiCAD/3d_models/NCS214RSQT2G.step

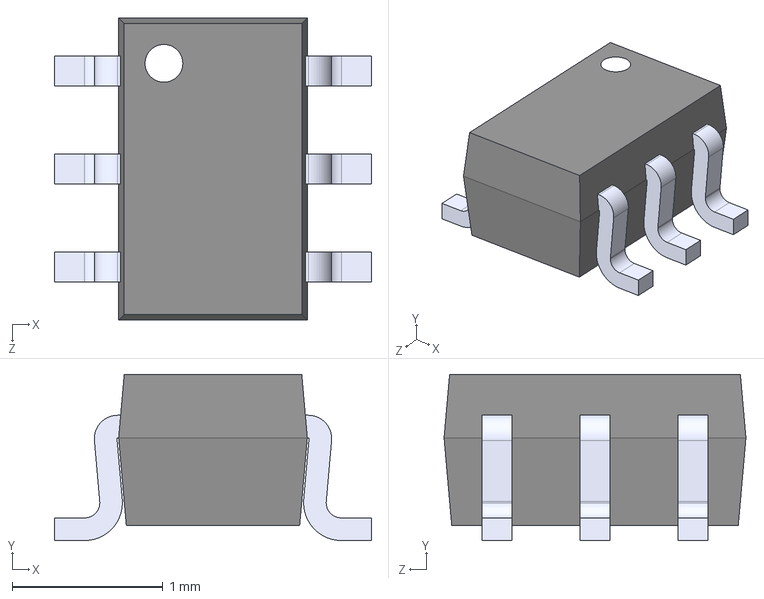
[picture p60: CAD file, 2023-07-27]
3d_models/NCS214RSQT2G.step
2.10 x 1.10 x 2.00 mm
