pollen-robotics/lib_KiCAD/3d_models/LQFP100.step

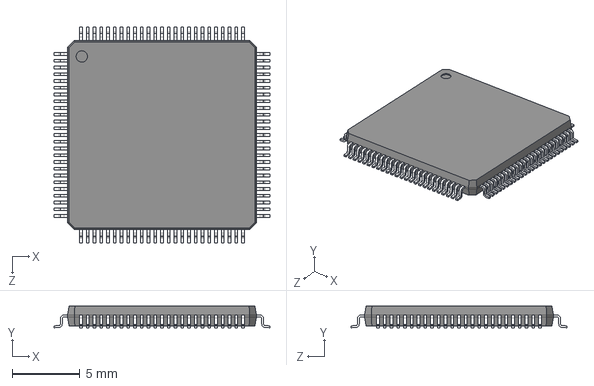
[picture p61: CAD file, 2023-07-27]
3d_models/LQFP100.step
16.0 x 1.60 x 16.0 mm
