pollen-robotics/lib_KiCAD/3d_models/usblc6-2sc6.stp

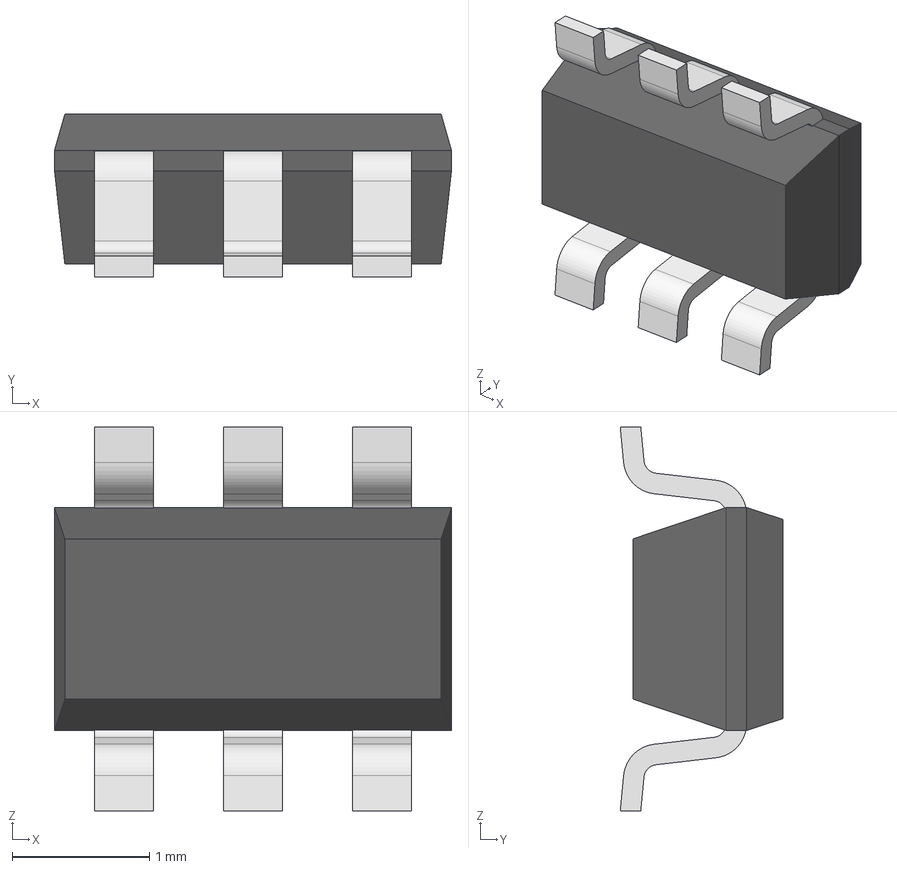
[picture p62: CAD file, 2023-07-27]
3d_models/usblc6-2sc6.stp
2.90 x 1.19 x 2.80 mm
