pollen-robotics/lib_KiCAD/3d_models/10uMax.step

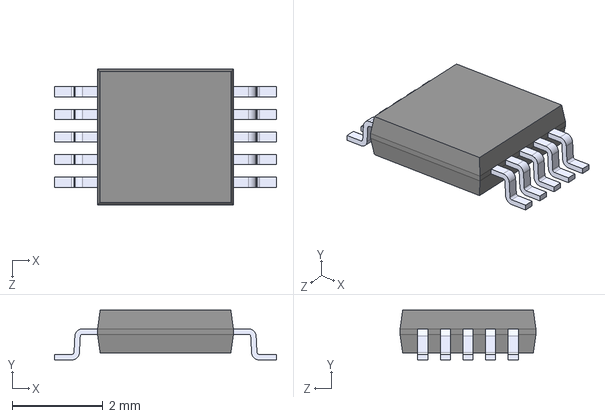
[picture p63: CAD file, 2023-07-27]
3d_models/10uMax.step
4.90 x 1.10 x 3.00 mm
