pollen-robotics/lib_KiCAD/3d_models/1-1734592-0.step

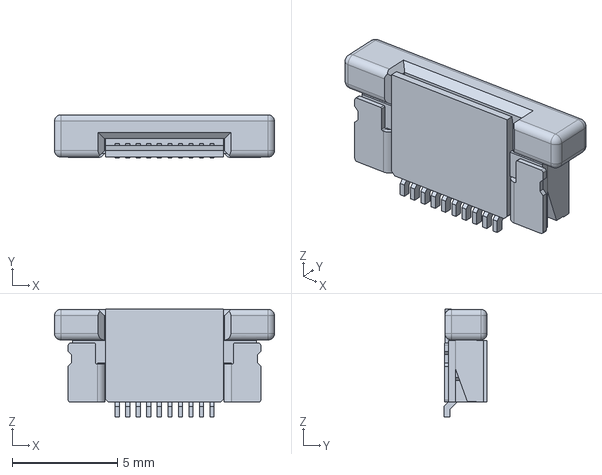
[picture p64: CAD file, 2023-07-27]
3d_models/1-1734592-0.step
10.4 x 2.05 x 5.11 mm
