pollen-robotics/lib_KiCAD/3d_models/BMI088.step

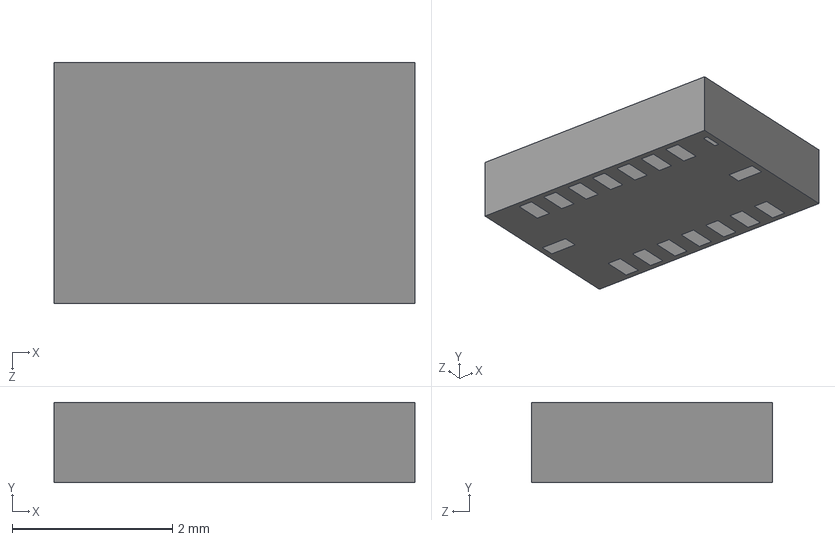
[picture p65: CAD file, 2023-07-27]
3d_models/BMI088.step
4.50 x 1.00 x 3.00 mm
