pollen-robotics/lib_KiCAD/3d_models/FH12-10S-0.5SH-55.step

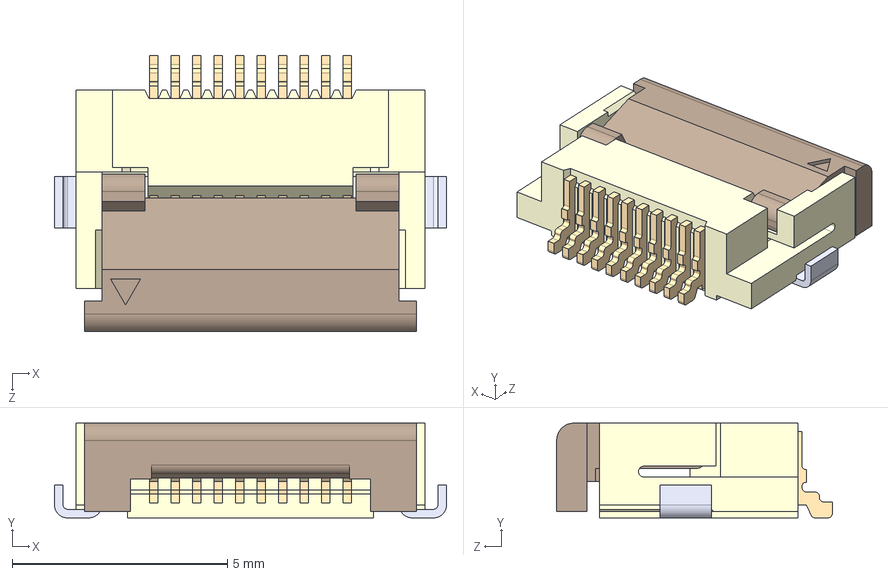
[picture p66: CAD file, 2023-07-27]
3d_models/FH12-10S-0.5SH-55.step
9.10 x 2.20 x 6.40 mm
