pollen-robotics/lib_KiCAD/3d_models/c-188275-8-u-3d.stp

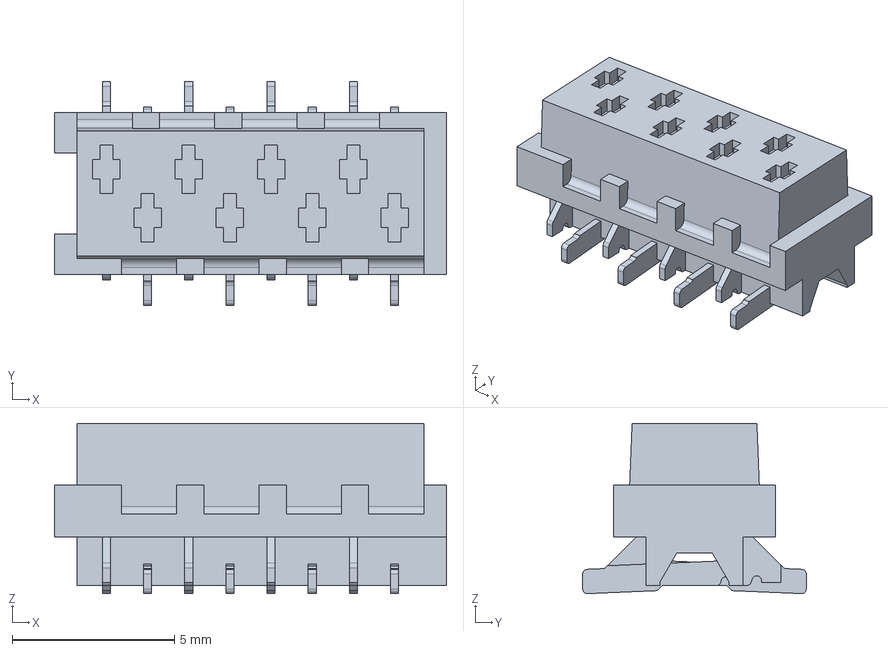
[picture p67: CAD file, 2023-07-27]
3d_models/c-188275-8-u-3d.stp
12.1 x 6.90 x 5.25 mm
