pollen-robotics/lib_KiCAD/(list of files, cad)

Other CAD files:
3d_models/1-1734839-0.stp
3d_models/10118194-0001LF.step
3d_models/43650-0210.stp
3d_models/43650-0310.stp
3d_models/43650-0321.stp
3d_models/53047-0310.stp
3d_models/9774025960R_spacer_3.3x2.5-Body.step
3d_models/9774025960R_spacer_3.3x2.5.FCStd
3d_models/JS102011SAQN.step
3d_models/PT61020EL.step
