pollen-robotics/lib_KiCAD/(commit log)

2023-07-27 Initial commit, those elements have been used on boards Houston, Major Tom, Pacman, Ticket and Ventouse.
    [1-1734592-0.step, 1-1734839-0.stp, 10118194-0001LF.step, 10uMax.step, 43650-0210.stp, 43650-0310.stp, ASE-xx.yyyMHZ-ET.stp, BMI088.step]
2023-08-28 [added] Extra connectors for Poulpe/Ventouse.
    [Molex_SPOX_5267-03A_Dynamixel.step, PT61020EL.step]
2023-11-17 Updated the USB micro-B connector.
    [10118194-0001LF.step]
2023-11-27 [added] Components used in elec_Wailers.
    [43650-0321.stp, capacitor_diam_12.5_code_H13.stp]
2023-12-11 [added] BOB [fixed] MicroFit vertical has solderable Mounting Pins
2023-12-11 [added] MicroFit Vertical footprint
2023-12-18 [added] Updated Molex MicroFit with 3d models.
    [Molex_43650-0200.stp, Molex_43650-0300.stp, capacitor_diam_6.3mm_P2.50mm_h11.step]
2024-01-17 [update] Molex Mega-Fit enters the place...
    [53047-0310.stp, Molex_MegaFit_2002411212.stp]
2024-01-17 [added] XT30 enters the game.
    [Amass_XT30PW-M_pcb solder.stp]
2024-01-29 [added] Fuse, Relay...
    [Amass_XT30U-F.stp, Amass_XT30U_M.step, Amass_XT90H-F.STEP, Amass_XT90H-M.STEP, Fuse_Holder_Schurter_8040.0001_03.STEP, Molex_436500215.stp, Molex_530470210.stp, Sensata_D06D100.stl]
2024-02-10 [update] Footprint QFN7xxx for TMC6100
2024-03-06 [added] Driver DRV8316.
2024-03-08 [added] 3d model of VQFN.
    [VQFN-40_5x7mm.stp]
2024-03-18 [added] Weird components (Dual MOS, wide 2512 resistor)…
    [KW_DSLP31_CC_20191212_geometry.STEP, Molex_502352-0400.stp, PQFN-12.step, QFN37_7X7_TRI.step]
2024-04-29 [update] User symbols/footprints.
2024-05-10 [added] Molex SlimStack.
    [Molex_529910208.stp, Molex_539160208.stp]
2024-05-20 [update] USB connector (still DRC errors!)
2024-06-03 [added] Updated footprints with 3d models link
2024-07-10 [fix] Movable #1 pin on silkscreen
2024-07-12 [added] Rsense (a bigger 1206)
    [ERJ8CWFR010V.step]
2024-08-23 [added] Some USB connectors.
    [Molex_105133-0001.stp, TE_5787834-1.stp]
2024-09-25 [adde] LTC6820
    [QFN-16 (3x3).stp]
2024-09-25 [fix] LTC6820 pin functions.
2024-09-25 [fix] AS5047 pin functions
2024-10-08 [added] LTC4331/2 for diff I2C/SPI
    [LPQFN20_ADI.step]
2024-10-08 [fix] LTC pin functions
2024-10-21 [added] Castellated holes connector for Aksim2
2024-10-22 [fixed] Adapted RLS Aksim pads connector.
2024-10-23 [update] RLS soldering pads added
2024-10-25 [update] Larger OAR for MicroFit mounting pads (required by EC)
2024-11-07 [added] MicroFit SMD + MP-TH
    [Molex_436500221.stp]
2024-11-08 [update] Light model of the relay
    [Sensata_D06D100.stl]
2024-11-08 [added] Templates
    [ASE00xyz-A1_elec_template_BOM.xlsx, template_PCB.kicad_pcb, template_SCH.kicad_sch]
2024-11-15 [added] Molex MicroF 2V
    [Molex_430450212.stp]
2025-02-03 [added] small switch
    [EOZ_09.03201.02.step]
2025-06-26 [added] Various components from JLCPCB
    [DC005_jack_barrel.STEP, FOO_USB-C_vert.STEP, PowerSO20.STEP, Shou Han - USB TYPE-C 16PIN 2MD -073---3DModel-STEP-269445.STEP, ss-3336s-02-l1.stp]
2025-09-02 [added] Components for zuuu-up.
    [Amass_XT90PB-F.STEP, MPKSLE60D20-L.step, Molex_430450612.stp, TE_1734366-1.stp]
2025-10-06 [added] Components for zuuu-up
    [Amphenol_LUSBA11100.STEP]
2025-11-14 [added] PCB Edge connector for SWD debugging
2025-11-20 [update] PowerPAK added
    [Vishay_SiC402_PowerPAK MLP55-32L.step]
2025-11-27 [added] Power PROFET (Solid-State Relay)
2025-12-03 [added] XT30 for PCB
    [Amass_XT30UPB-F.step]
2026-01-26 [added] Introducing LCSC parts (extracted with easyeda2kicad)
    [raps_CM4 -Light.step, rasp_AI_HAT_Plus.stp, rasp_Cooler_RPI_CMx.step]
2026-02-02 [added] FPC-connector
2026-02-09 [added] SIL connector
2026-02-09 [added] Parts for microDwitch
    [Molex_0530470410.stp]
2026-02-17 [added] LCSC + updated XT30
2026-02-24 [added] Raspberry pi 2 W
    [rasp_pi_zero_2_W_with_40_pin_male_connector v4.step]
2026-03-04 [fixed] Wago 2 connector - 3D step
2026-03-20 [added] Component for Grabette
    [Kailh_Choc_Low_Profile_Switch.step]
2026-03-25 [added] Kaihl switch low profile
2026-04-16 [added] Pogo-pin and SMD-M2,5_spacer for Gripette
    [Molex_pico4_TH_RA_0530480410.stp]
2026-04-16 [added] Pico4 T Pico4 THH
    [Molex_pico4_TH_0530470410.stp]
2026-06-02 [added] USB connector for Grabette/Gripette
2026-07-08 [added] Component for the NFC board.
2026-07-10 [added] CLRC663 3d model
    [HVQFN-32_L5.0-W5.0-P0.50-TL-EP3.1.step]
2026-07-16 [fix] USB-C/3 pin locator [add] NFC Antenna
2026-07-17 [update] NFC Antenna
2026-07-20 [fixed] Antenna can be fully routed (as they are considered as net ties)
2026-07-21 [update] Rounded edge on the antenna
2026-09-04 [added] XT + spacer for elec_tartine
    [9774025960R_spacer_3.3x2.5-Body.step, 9774025960R_spacer_3.3x2.5.FCStd]
2026-09-15 [added] Components for elec_poussah
    [RQM0029A.stp]
2026-09-16 [update] BQ charger
    [header_3p_215297-3.step]
2026-10-06 [added] small screw terminal
2026-11-09 [fixed] CM4 pin functions for ERC
